fjpolo/ProtocolEmulatorr/html/Jane Street Blog - Can you design a chip_ Announcing the protocol emulator ASIC competition_files/youtube.png

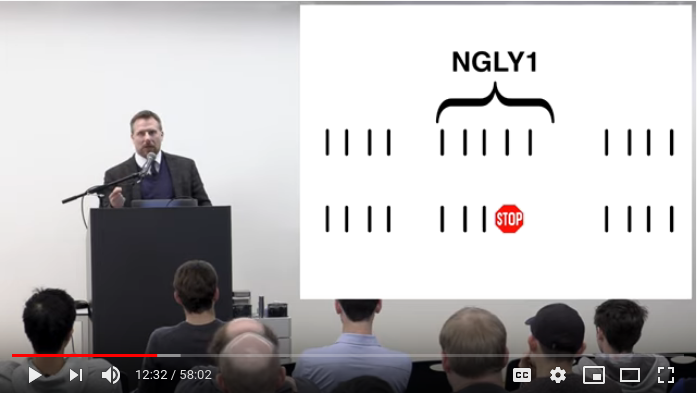
html/Jane Street Blog - Can you design a chip_ Announcing the protocol emulator ASIC competition_files/youtube.png
