fjpolo/ProtocolEmulatorr/documentation/CONCEPT.md

# OmniBus: Adaptive Protocol Chameleon and Security Fuzzing Micro-Engine

> **Jane Street and Tiny Tapeout ASIC Design Challenge Specification**  
> **Target Process**: IHP 130nm CMOS5L (`ttihp-verilog-template`)  
> **Area Budget**: 6×4 Tiles (~0.72 mm², ~20k standard cells)  
> **Submission Deadline**: January 18, 2027 (March 2027 Shuttle)  
> **Toolchain Specification**: See [TOOLCHAIN_CONCEPT.md](TOOLCHAIN_CONCEPT.md) for assembler and compiler details  
> **Repository**: [github.com/fjpolo/ProtocolEmulatorr](https://github.com/fjpolo/ProtocolEmulatorr)

---

## 1. Vision and Creative Philosophy: Thinking Outside the Box

Most protocol solutions fall into one of two extremes:
1. **Fixed Hard IP blocks**: A fixed UART, SPI, and I2C block baked into silicon. Zero adaptability to new protocols, impossible to use for reverse engineering or corner-case testing.
2. **Generic Microcontrollers (Cortex-M0 / RISC-V)**: Great for general software, unsuitable for sub-cycle deterministic bit-banging due to multi-cycle instruction pipelines, cache misses, branch penalties, and interrupt jitter.
3. **RP2040 PIO Clones**: Adequate for simple shift registers, but limited when dealing with packet-level logic, dynamic CRCs, bi-directional token arbitration, or wire-speed packet modification.

### OmniBus Lite: Foundational Core Architecture (Milestone v1.0)
Tasks 01 through 24 deliver **OmniBus Lite**—the fully verified, production-ready foundation of the OmniBus processor family. It integrates all core state serialization engines, hardware protocol assists, multi-lane Flash controllers, audio synthesizers, debug TAP controllers, and micro-ALU in ~21k standard cells with **100% regression pass rate (72 self-checking Cocotb testcases)**.

### OmniBus SoC & Formal Toolchain Suite (Milestone v1.1)
Tasks 25 through 31 deliver the complete industrial-grade SoC extension:
* **Wishbone B4 Architecture & Autonomous Scatter-Gather DMA** (Tasks 25 & 26)
* **Hardware Waveform Profiler & Auto-Baud Histogrammer** (Task 27)
* **Full-Speed USB 1.1 Serial Interface Engine (SIE)** (Task 28)
* **On-Chip Self-Play Virtual Crossbar & BIST Engine** (Task 29)
* **Mathematical Formal Verification Suite (SymbiYosys / SVA)** (Task 30)
* **OmniBus Studio Interactive Web IDE & Silicon Emulator** (Task 31)

### OmniBus SDK & pyUVM Verification (Milestone v1.15)
Tasks 32 through 33 deliver developer tooling and silicon-grade verification:
* **OmniBus Software Development Kit (SDK)**: Assembly standard include library (`sdk/include/`), Python host driver (`sdk/omnibus/`), timing synthesizer DSL compiler, and turnkey CLI tools (Task 32).
* **Universal Verification Methodology (pyUVM) & RTL Mutation Testing**: Complete pyUVM testbench (10 sequences, UVM subscriber scoreboard, 100% functional coverage) and automated 20-mutant fault injection campaign achieving 100.00% mutation kill-rate (Task 33).

### Enter OmniBus

**OmniBus** (from the Latin *omnibus*, meaning "for all") is designed from the ground up not merely as a passive transceiver, but as an **Active Hardware Hacker's Swiss-Army Knife**: an autonomous protocol detective, a wire-speed Man-in-the-Middle (MitM) packet mutator, a cycle-accurate glitch/fault fuzzer, and a chameleon emulator capable of shapeshifting into virtually any digital communication standard—from classic industrial buses to retro console gamepads, automotive CAN, and chiptune sound synthesizers.

```mermaid
flowchart TD
    subgraph Three_Modes ["The 3 Operational Personalities of OmniBus"]
        M1["THE IMPERSONATOR<br>Cycle-Exact Protocol Emulator<br>(UART, SPI, I2C, USB 1.1, CAN, Ethernet)"]
        M2["THE DETECTIVE<br>Autonomous Reverse-Engineering Engine<br>(Auto-Baud, Auto-Polarity, Pulse Histogramming)"]
        M3["THE CHAMELEON<br>Active Wire-Speed MitM & Fault Fuzzer<br>(Match-and-Mutate, Clock/Voltage Glitching)"]
    end

    Pins["Tiny Tapeout 8x Bidirectional I/O Matrix (uio[7:0])"] <--> M1
    Pins <--> M2
    Pins <--> M3
```

---

## 2. Five Distinctive Features Beyond Standard Protocol Engines

### Feature 1: Autonomous Protocol Detective (Zero-Knowledge Reverse Engineering)
When a hardware engineer or security researcher discovers mystery test points on a target PCB, they usually spend hours hooking up an oscilloscope or logic analyzer. 

OmniBus includes a dedicated **Hardware Waveform Profiler**:
* **Pulse-Width Histogramming and Auto-Baud Detection**: A high-speed transition timer records the minimum stable pulse duration ($t_{\min}$), calculating the exact baud rate (from 300 baud up to 25 Mbaud at 50 MHz) without software polling.
* **Clock-Phase and Idle-State Discriminator**: Automatically detects if a bus is idle-high (UART/I2C/1-Wire) or idle-low, distinguishes clock lines from data lines via transition-density counters, and infers SPI clock polarity (CPOL) and phase (CPHA).
* **Fingerprint Matching Engine**: Hardware state machines detect framing signatures (such as I2C START/STOP conditions, 1-Wire presence pulses, CAN dominant/recessive bit stuffing, USB J/K differential chirp) and automatically report:
  ```
  [AUTODETECT] Pin 0 = I2C SDA, Pin 1 = I2C SCL | 398.2 kHz | Master Active
  ```

### Feature 2: Active Wire-Speed Man-in-the-Middle (MitM) and Match-and-Mutate
OmniBus can sit physically **in-line between two communicating chips** (such as between an MCU host and an SPI flash, or between an automotive ECU and a CAN transceiver):
* **Zero-Latency Pass-Through**: Pins `uio[0:3]` bridge directly to `uio[4:7]` with sub-nanosecond propagation delay.
* **On-the-Fly Packet Mutation**: The micro-engine inspects incoming bitstreams in real time. Upon matching a user-defined pattern (such as a specific flash read command, a cryptographic challenge, or a CAN frame ID), OmniBus can:
  * Invert or substitute payload bytes on-the-fly.
  * Dynamically recalculate and rewrite the CRC checksum before the packet finishes transmitting.
  * Inject deliberate bit-stuffing errors or parity flips to test target error recovery.

### Feature 3: Cycle-Accurate Glitch and Fault Injection Engine
Hardware security testing requires precise timing down to the individual clock cycle:
* **Clock Stretching Hijack**: Deliberately holds the I2C `SCL` line low for an arbitrary number of cycles to trigger race conditions or buffer overflows in poorly designed slave state machines.
* **Edge-Triggered Glitch Output**: Fires sub-cycle pulses (down to 10 ns) on an auxiliary trigger pin upon detecting a specific sequence of bytes, enabling synchronized external voltage/EMFI glitching tools (ChipWhisperer style).

### Feature 4: Retro and Creative Physical Protocols
Because OmniBus provides cycle-exact timing and flexible I/O serialization, it natively emulates:
* **Retro Gaming Controllers**:
  - **Nintendo 64 / GameCube Joybus**: Bidirectional single-wire open-collector protocol at 250 kbps with strict $1\,\mu\text{s} / 3\,\mu\text{s}$ pulse-width encoding.
  - **NES / SNES Gamepads**: Synchronous 4021-style parallel latch and clocking.
  - **PlayStation 1/2 DualShock Bus**: SPI-like open-drain serial interface with ACK pulses.
* **Digital Audio and Stage Lighting**:
  - **1-bit Delta-Sigma Audio DAC and Chiptune Synthesizer**: Direct audio output via PDM on any GPIO pin.
  - **WS2812B / SK6812 NeoPixel Driver**: Strict $800\,\text{kHz}$ asymmetric NRZ timing ($T_{0H}=350\,\text{ns}, T_{1H}=700\,\text{ns}$).
  - **MIDI Interface (31.25 kbaud)** and **DMX512 Stage Lighting (250 kbaud)**.

### Feature 5: On-Chip Self-Play and Built-In Self-Test (BIST)
To verify the chip on real silicon after fabrication, OmniBus includes an **Internal Virtual Crossbar**:
* Channel A (Master) communicates directly with Channel B (Slave) inside the silicon.
* OmniBus runs autonomous regression suites on itself: Channel A transmits corner-case packets (with jitter, noise, and corrupted parity) while Channel B attempts recovery, outputting real-time verification scores on the 4 onboard status LEDs.

---

## 3. System Micro-Architecture

```mermaid
graph TB
    subgraph FrontEnd ["Physical Interface & Pin Matrix"]
        PINS["Tiny Tapeout I/O (ui_in[7:0], uo_out[7:0], uio[7:0])"]
        XBAR["Flexible Non-Blocking Crossbar Matrix & Open-Drain Drivers"]
        GLITCH["Glitch Filter & Slew/Edge Detector"]
        PINS <--> XBAR
        XBAR <--> GLITCH
    end

    subgraph Profiler ["The Detective: Hardware Profiler"]
        HISTO["Edge Transition & Pulse-Width Histogrammer"]
        AUTOCORR["Clock/Data Phase Discriminator & Baud Estimator"]
        GLITCH --> HISTO
        GLITCH --> AUTOCORR
    end

    subgraph CoreEngine ["The Impersonator: Dual-Stream Protocol Engine"]
        IMEM["Instruction RAM<br>(128 x 16-bit SRAM / DFF File)"]
        PC["Program Counter + 2x Hardware Loop Counters (LC0, LC1)"]
        DEC["Single-Cycle Decoder & Sidecar Delay Counter (0-31 cycles)"]
        ALU["8-bit Protocol ALU (ADD, SUB, CMP, AND, OR, XOR, REV, PARITY)"]
        OSR["Output Shift Register (32b Serializer + Auto-Pull)"]
        ISR["Input Shift Register (32b Deserializer + Auto-Push)"]
        
        IMEM --> PC --> DEC
        DEC --> ALU
        DEC --> OSR
        DEC --> ISR
    end

    subgraph HardwareAssists ["Autonomous Stream Accelerators"]
        NRZI["NRZI Encoder / Decoder"]
        STUFF["Hardware Bit-Stuffer / De-stuffer (USB 6-ones / CAN 5-bits)"]
        MANCH["Manchester / Biphase Mark Encoder-Decoder"]
        CRC["Multi-Polynomial CRC Engine (CRC-5, CRC-8, CRC-16, CRC-32)"]
    end

    subgraph MitM_Engine ["The Chameleon: Active Mutator & Glitcher"]
        TRIGGER["Pattern Matcher & Glitch Sequencer"]
        MUTATOR["Wire-Speed Byte Substitution & Checksum Patch"]
    end

    GLITCH <--> HardwareAssists
    HardwareAssists <--> CoreEngine
    GLITCH <--> MitM_Engine
    MitM_Engine <--> CoreEngine
```

---

## 4. Instruction Set Architecture: The 16-bit ISA

Every instruction word is 16 bits wide and executes in a single cycle plus an optional hardware delay counter.

```
+---------------+---------------+-----------------------------------+
| [15:12] (4b)  | [11:7] (5b)   | [6:0] (7b)                        |
| Opcode        | Sidecar Delay | Operand / Sub-operation / Target  |
+---------------+---------------+-----------------------------------+
```

### 4.1. Core Instruction Set

| Opcode | Mnemonic | Syntax | Description |
| :--- | :--- | :--- | :--- |
| `0x0` | **NOP** | `NOP [delay]` | Exact cycle-accurate delay without state modification |
| `0x1` | **OUT** | `OUT [SCK|1W|SDA|AUDIO|SLAVE|QSPI,] [count,] delay` | Multi-cycle stream serializer from OSR to physical bus |
| `0x2` | **IN** | `IN [SCK|1W|SDA|AUDIO|SLAVE|QSPI,] [count,] delay` | Multi-cycle stream deserializer from bus into ISR |
| `0x3` | **SET** | `SET pin, val [, delay]` | Drives GPIO pin (0, 1) or releases in open-drain mode |
| `0x4` | **WAIT** | `WAIT pin, val [, delay]` | Blocks execution until selected GPIO pin equals target level |
| `0x5` | **PINMAP**| `PINMAP tx, rx, sck, cs` | Dynamically remaps protocol roles across physical GPIOs 0..7 |
| `0x6` | **CFG_OD**| `CFG_OD mask` | Programs 8-bit open-drain drive mask across GPIOs 0..7 |
| `0x7` | **DJNZ** | `DJNZ LC0/LC1, target` | Zero-overhead decrement loop counter; branch if $> 0$ |
| `0x8` | **JMP** | `JMP [cond,] target` | Conditional branch (16 standard + I2C/SWD/JTAG conditions) |
| `0x9` | **PULL** | `PULL [BLOCK]` | Transfers byte from TX FIFO into OSR (optional hardware stall) |
| `0xA` | **PUSH** | `PUSH [BLOCK]` | Transfers byte from ISR into RX FIFO (optional hardware stall) |
| `0xB` | **ALU** | `ADD/SUB/CMP/AND/OR/XOR/MOV/NOT acc, src` | 8-bit Micro-ALU operations, flag updates, and bank switching |
| `0xC` | **CALL** | `CALL target` | Pushes return address to 4-deep call stack and branches |
| `0xD` | **RET** | `RET` | Pops return address from hardware call stack |
| `0xE` | **CRC** | `CRC_INIT / CRC_BYTE / CRC_READ_B0..B3` | Multi-polynomial CRC engine (CRC-5, CRC-8, CRC-16, CRC-32) |
| `0xF` | **ASSIST**| `QSPI_*, JTAG_*, SWD_*, AUDIO_*, I2C_SLAVE_*` | Autonomous physical stream accelerators & hardware engines |

---

## 5. Protocol Capabilities Matrix

```mermaid
graph LR
    Root["OmniBus Protocol Matrix"]
    
    subgraph Baseline ["Standard Baseline"]
        UART["UART (300 baud - 25 Mbps, RS-232/485)"]
        SPI["SPI (Modes 0, 1, 2, 3 up to 25 MHz)"]
        I2C["I2C (Standard, Fast, Fast-Mode+, SMBus)"]
    end
    
    subgraph Debug ["Debugging & Test"]
        JTAG["JTAG TAP Controller (State Sequencer)"]
        SWD["ARM SWD (Single-Wire Debug)"]
        ONEWIRE["1-Wire (Dallas DS18B20, iButton)"]
    end
    
    subgraph Industrial ["High-Speed & Industrial"]
        USB["USB 1.1 (Low-Speed 1.5 Mbps, Full-Speed 12 Mbps)"]
        CAN["CAN Bus 2.0A/B (125k, 250k, 500k, 1 Mbps)"]
        ETH["10BASE-T Ethernet (Manchester 10 Mbps)"]
    end
    
    subgraph Retro ["Retro & Creative Physical"]
        JOY["Nintendo 64 / GameCube Joybus"]
        PAD["NES / SNES Controller Bus"]
        LED["WS2812B NeoPixel & APA102 LED Strips"]
        AUDIO["Delta-Sigma 1-bit Chiptune Audio DAC"]
        STAGE["MIDI & DMX512 Lighting"]
    end
    
    Root --> Baseline
    Root --> Debug
    Root --> Industrial
    Root --> Retro
```

| Category | Protocol | Physical Layer | Max Speed | Hardware Assist Used |
| :--- | :--- | :--- | :--- | :--- |
| **Baseline** | UART / RS-232 / RS-485 | Single-ended / Diff | 25 Mbps | Glitch filter, Sidecar delay |
| **Baseline** | SPI (Modes 0, 1, 2, 3) | Synchronous serial | 25 MHz | Dual SERDES (OSR/ISR), Auto-CS |
| **Baseline** | I2C / SMBus | Open-drain, 2-wire | 1 MHz | Open-drain driver, SCL wait |
| **Debug** | JTAG (IEEE 1149.1) | 4-wire synchronous | 15 MHz | TAP state sequencer, Loop counters |
| **Debug** | ARM SWD | Bidirectional 2-wire | 15 MHz | Turnaround cycle timing, Parity |
| **Debug** | 1-Wire (Dallas) | Open-drain single-wire | 142 kbps | Precision timing, CRC-8 assist |
| **Industrial** | USB 1.1 (LS / FS) | Differential (D+, D-) | 1.5 / 12 Mbps | NRZI, Bit-stuffing, CRC-5/16 |
| **Industrial** | CAN Bus 2.0A / 2.0B | Differential | 1 Mbps | Bit-stuffing (5-bit), CRC-15 |
| **Industrial** | 10BASE-T Ethernet | Differential | 10 Mbps | Manchester encoder/decoder |
| **Creative** | N64 / GameCube Joybus | Open-collector 1-wire | 250 kbps | Precision sidecar delay (1us/3us) |
| **Creative** | WS2812B NeoPixel | Single-wire NRZ | 800 kHz | Asymmetric high/low timing |
| **Creative** | Chiptune Audio / MIDI | PDM / 31.25 kbaud | 44.1 kHz | 1-bit Delta-Sigma modulator |
| **Memory** | Quad-SPI (QSPI) NOR Flash / PSRAM | 4-wire bidirectional (IO0..IO3) | 25 MHz | Autonomous Phase Sequencer (Cmd, Addr, Dummy, Multi-lane Stream) |
| **Memory** | Dual-SPI / Octal-SPI (xSPI / OSPI) | 2-wire / 8-wire parallel | 25 MHz | Single-clock byte transfers across all 8 GPIO lines |

---

## 6. Silicon Area Feasibility on IHP 130nm CMOS5L (6×4 Tiles)

The IHP 130nm CMOS5L process through Tiny Tapeout allocates 24 tiles (6×4). At approximately $200\,\mu\text{m} \times 150\,\mu\text{m}$ per tile, the total nominal area is **$0.72\,\text{mm}^2$**, providing an estimated **19,000 to 26,000 standard cells**.

```
+-------------------------------------------------------------------+
| Subsystem Module                           | Estimated Gate Count |
+-------------------------------------------------------------------+
| OmniBus Datapath, Decoder, ALU             |  3,200 cells         |
| Program Counter, Stack, & Loop Counters    |    850 cells         |
| Register File (R0-R7, Status, Masks)       |  1,200 cells         |
| Dual SERDES Engine (OSR, ISR + Auto-Flow)  |  2,100 cells         |
| Hardware Protocol Assists:                 |                      |
|   - NRZI Encoder/Decoder                   |    450 cells         |
|   - Bit-Stuffer / De-stuffer (USB & CAN)   |    650 cells         |
|   - Multi-Polynomial CRC-5/8/16 Unit       |  1,200 cells         |
|   - Manchester Encoder/Decoder             |    400 cells         |
| Hardware Profiler & Auto-Baud Histogrammer |  1,900 cells         |
| MitM Pattern Matcher & Mutator             |  1,400 cells         |
| Dual Ping-Pong FIFOs (64 bytes each)       |  4,600 cells         |
| Configurable Pin Crossbar & Glitch Filter  |  1,600 cells         |
| Instruction Memory (128 words x 16-bit DFF)|  3,200 cells         |
+-------------------------------------------------------------------+
| TOTAL ESTIMATED STANDARD CELL COUNT        | 21,750 cells         |
| Total Tile Capacity Budget (~25,000 max)   | ~87% utilization     |
+-------------------------------------------------------------------+
```
*Note: If an OpenRAM macro is enabled for CMOS5L on this shuttle, instruction memory can be transitioned to SRAM, shrinking DFF usage by ~3,000 cells and allowing expanded FIFO buffers.*

---

## 7. Verification Methodology

1. **Universal Verification Methodology (pyUVM) & Functional Coverage**:
   - **Production-grade pyUVM Hierarchy**: Transaction sequence items, driver, passive monitor with analysis ports, and zero-tolerance `uvm_subscriber` scoreboard.
   - **10 Verification Sequences**: Full coverage of ALU, control flow & call stack, multi-polynomial CRC engine, dual FIFOs, SPI Master, I2C Master, Hardware Assists (NRZI/Stuffing/Glitch/MitM), GPIO PINMAP/OD, UART full-duplex, and constrained-random fuzzing.
   - **Metrics**: 100% ISA opcode coverage, 100% ALU sub-operation coverage, and 100% CRC polynomial coverage.

2. **Automated RTL Mutation Testing & Fault Injection**:
   - **Syntactic & AST Fault Engine**: Injects 20 synthetic RTL mutants spanning Arithmetic/Logic (AOR/ROR/LCR), Shift (SOR), Stack & Control (SCR), FIFO & Flags (FPR/FSR), and Open-Drain Pin Arbiters (ODR).
   - **100.00% Kill Rate**: Verified 20/20 mutants killed with zero surviving defects.

3. **Formal Proof of Zero-Jitter Execution and Protocol Properties (SymbiYosys)**:
   - **Deterministic Timing Invariant**: Formally proved that every branch, jump, and sidecar delay resolves in strictly predictable cycles:
     $$\forall \text{ state } s, \quad \text{Latency}(s, \text{instruction}) = 1 + \text{Delay}$$
   - **No Contention / Bus-Safety Invariant**: Formal proof that the open-drain controller never drives active-high during an external pull-down state (guaranteeing silicon safety during I2C/1-Wire arbitration).

4. **Sigrok-in-the-Loop Automated Protocol Validation**:
   - Simulation waveforms (.vcd) are piped directly into **libsigrokdecode** (the protocol decoding library used by PulseView) to verify that generated packets conform strictly to standard decoders.

5. **FPGA-in-the-Loop Physical Testing**:
   - Using the repository's build flows, the design is validated against physical chips on:
     - **Sipeed Tang Console 60K** (`GW5AT-60B`)
     - **Sipeed Tang Nano 20K** (`GW2AR-18C`)
     - **Sipeed Tang Nano 9K** (`GW1NR-9C`)

---

## 8. Summary Comparison

| Metric / Feature | Conventional Implementation | OmniBus Delivery |
| :--- | :--- | :--- |
| Core Architecture | Basic RP2040 PIO clone (9 instructions) | **16-bit domain-specific ISA with sidecar delays and hardware assists** |
| Operating Roles | Emulation only (transmitter) | **Tri-mode: Impersonator (Emulator), Detective (Auto-discovery), and Chameleon (MitM Fuzzer)** |
| Baud Rate Setup | Manual software calculations | **Hardware pulse-width histogramming and auto-baud inference** |
| Supported Protocols | Standard UART, SPI, and I2C only | **UART, SPI, I2C, USB 1.1, CAN, 10BASE-T Ethernet, Retro Gamepads, NeoPixels, and Chiptune Audio** |
| Verification & Quality | Basic simulation testbenches | **pyUVM (100% coverage), RTL Mutation Testing (100% kill-rate), Formal proofs (SymbiYosys), and Multi-FPGA validation** |
