fjpolo/ProtocolEmulatorr/documentation/DATASHEET.md

# OmniBus ProtocolEmulator ASIC Datasheet
**High-Performance Autonomous Multi-Protocol Emulation Core**  
**Document Revision**: 1.15 (Architecture Release — Tasks 01 through 33)  
**Architecture Milestone**: OmniBus Production Silicon (v1.15 Release)  
**Target ASIC / FPGA**: Jane Street Silicon / Gowin GW5AST-LV138FPG676A / Generic ASIC Standard Cell  
**Dedicated User Guides**: [task33.md](task33.md) (pyUVM Verification & RTL Mutation Testing), [task32.md](task32.md) (Software Development Kit), [task31.md](task31.md) (Web IDE & Visual Emulator), [task30.md](task30.md) (Formal SVA Verification), [task28.md](task28.md) (USB 1.1 Autonomous SIE), [task27.md](task27.md) (Waveform Profiler & Auto-Baud), [GLITCH_MITM_USER_GUIDE.md](GLITCH_MITM_USER_GUIDE.md) (Fault Injection & MitM Fuzzing), [task26.md](task26.md) (OmniBus DMA Controller)  

---

## 1. Device Overview & Key Features

The **OmniBus ProtocolEmulator** is a deterministic, microcode-programmable physical-layer communications processor designed to replace dedicated fixed-function protocol controllers (UART, SPI, I2C Master/Slave, SMBus, 1-Wire, USB 1.1, CAN 2.0, WS2812B, NES/SNES Gamepad, 10BASE-T Ethernet, S/PDIF, DALI, 1-Bit Delta-Sigma Audio DAC, IEEE 1149.1 JTAG, ARM Serial Wire Debug SWD, Quad-SPI & Octal-SPI Multi-Lane Flash/PSRAM Host) with a unified, high-speed ASIC architecture.

```
                           +---------------------------------------+
                           |       OmniBus ProtocolEmulator        |
                           |                                       |
    [Host System] <======> | [Wishbone B4 Slave]   [128-word IMEM] | <======> [Physical Pins]
    (Wishbone / FIFO)      | [Synchronous Dual FIFO]  (4 Banks)    |          (8-bit Unified GPIO)
                           | [Micro-ALU]         [SERDES Engine]   |          - Push-Pull / OD
                           | [32-bit CRC Engine] [Pulse Engine]    |          - Dynamic PINMAP
                           | [Stream Stuffer]    [NRZI Modulator]  |          - Manchester / BMC
                           | [I2C Slave Engine]  [Clock Stretch]   |          - Open-Drain I2C
                           | [Delta-Sigma DAC]   [4-Voice APU]     |          - PDM / BTL Audio
                           +---------------------------------------+
```

### Key Architectural Specifications
- **USB 1.1 Autonomous Serial Interface Engine (Task 28)**:
  - **Zero-CPU Full-Speed (12 Mbps) & Low-Speed (1.5 Mbps) SIE**: Autonomous differential line decoding (`D+`, `D-` $\to$ J, K, SE0, SE1), mid-bit eye-diagram alignment, and hardware bit-stuffing/de-stuffing.
  - **Autonomous Packet Verification & Filtering**: Hardware SYNC lock (`0x80`), PID complement verification (`PID[7:4] == ~PID[3:0]`), 7-bit Device Address and 4-bit Endpoint parsing, and token CRC-5 validation.
  - **Hardware Data CRC-16 Engine & Auto-Handshake Responder**: Reflective polynomial CRC-16 computation ($G(x) = x^{16} + x^{15} + x^2 + 1$, residual `0xB001`) and autonomous sub-microsecond `ACK`, `NAK`, `STALL` handshake generation.
  - **Bus Reset & EOP Handling**: Autonomous detection of sustained SE0 ($\ge 32$ bit times) indicating Bus Reset, and valid End-of-Packet (EOP) framing detection.
  - **Full Host & Microcode Integration**: Wishbone slave registers (`0x60..0x6C`), microcode opcodes (`USB_CFG`, `USB_SIE_EN`, `USB_SIE_DIS`, `USB_SEND_ACK`, `USB_SEND_NAK`, `USB_SEND_STALL`, `USB_TX_TOKEN`, `USB_TX_DATA`), and `ASSIST READ` targets (`USB_STATUS`, `USB_TOKEN`, `USB_DATA`, `USB_ADDR`).
- **Task 29: On-Chip Self-Play & Virtual Crossbar (BIST Engine)**:
  - **Internal Virtual Crossbar**: Direct Self-Loopback, Split Dual-Channel (Channel A Master <-> Channel B Slave), and pseudo-random jitter/stress injection.
  - **Hardware BIST Scoring**: 16-bit Vector, Pass, and Fail counters with sticky fail flag and real-time LED visualizer.
  - **Memory Map & Opcodes**: Wishbone slave registers (`0x70..0x78`), microcode opcodes (`BIST_DIS`, `BIST_LOOP`, `BIST_SPLIT`, `BIST_JITTER`, `BIST_START`, `BIST_STOP`, `BIST_RST`, `BIST_PASS`, `BIST_FAIL`, `BIST_STAGE`), and `ASSIST READ` targets (`BIST_STATUS`, `BIST_PASS`, `BIST_FAIL`, `BIST_VEC`).
- **The Protocol Detective: Autonomous Waveform Profiler & Auto-Baud Engine (Task 27)**:
  - **Zero-Knowledge Hardware Pulse Analyzer**: 16-bit transition timer running at 50 MHz (20 ns resolution) tracking minimum stable high/low pulse widths ($t_{\min\_high}, t_{\min\_low}$) and fundamental bit period ($t_{\min}$ auto-baud divisor).
  - **Bus Idle State & Duty-Cycle Symmetry Discriminator**: Classifies idle polarity (Idle-High vs. Idle-Low) and discriminates between periodic clocks ($t_{	ext{high}} pprox t_{	ext{low}}$) and asynchronous serial data.
  - **Autonomous Framing Signature Recognizer**: Real-time identification of I2C START/STOP, UART start/stop frames, 1-Wire reset (>400 µs), and SPI clock/chip-select coordination.
  - **Configurable Noise Filter & Telemetry Registers**: Digital glitch suppression (1..15 cycles) and host Wishbone registers (`0x50..0x5C`) with microcode instructions (`PROFILER_CFG`, `PROFILER_ARM`, `PROFILER_STOP`, `PROFILER_RST`, `JMP PROFILER_DONE`, `JMP PROFILER_CLOCK`).
- **OmniBus DMA Scatter-Gather Controller & Host Memory Streamer (Task 26)**:
  - **32-Bit Wishbone B4 Master Interface**: Autonomous direct memory access engine driving host memory bus cycles (`o_m_wb_cyc`, `stb`, `we`, `addr`, `data`, `sel`) with sub-word byte masking.
  - **Dual-Channel Concurrent Streaming**: Independent TX (Host Memory $\to$ TX FIFO) and RX (RX FIFO $\to$ Host Memory) channels with round-robin memory bus arbitration.
  - **Hardware Scatter-Gather Descriptor Traversal**: 16-byte linked-list descriptor processor (`buf_addr`, `length/flags`, `next_desc`, `status`) with automatic in-place byte count writebacks and End-of-Transmission (EOT) termination.
  - **Hardware Interrupts & Abort**: Dedicated interrupt generation (`o_irq`) upon channel completion, with instantaneous soft abort reset control.
- **Deterministic Zero-Jitter Execution Engine**: Microcode instructions execute in single clock cycles with precision cycle-accurate sidecar delays (up to 5,110 cycles per bit or runtime dynamic baud divisor).
- **1-Bit Delta-Sigma Audio DAC & 4-Voice Chiptune APU Synthesizer**: 50 MHz 1st-order Delta-Sigma ($\Sigma$-$\Delta$) PDM modulator with $OSR = 1250\times$, single-ended and differential BTL outputs on GPIO pins, 4 polyphonic synthesizer voices (Pulse 1, Pulse 2 with 4 duty cycles, 16-step Triangle, 15-bit/7-bit Galois LFSR Noise), saturation-clamped mixer ($V \le 255$), autonomous hardware sound effects (`BEEP`, `BLIP`, `ERROR`, `COIN`, `LASER`, `SIREN`, `NOISE`), and single-cycle PCM streaming (`OUT AUDIO`).
- **Hardware Glitch / Fault Injection & Active Wire-Speed MitM Fuzzing Engine**:
  - **Sub-Cycle Precision Crowbar & Glitch Pulse Generation**: 16-bit countdown delay (0 to 65,535 clock cycles, 20 ns resolution @ 50 MHz), 8-bit pulse width duration (1 to 255 clock cycles), selectable polarity (active-High trigger pulse or active-Low crowbar pulldown), and independent target pin routing (any GPIO 0..7).
  - **Autonomous Wire-Speed Pattern Matcher**: Single-cycle pattern comparison (`mitm_match_byte[7:0]`) with configurable wildcard bitmask (`mitm_mask[7:0]`). Immediate zero-jitter autonomous trigger-on-match starts glitch countdown upon detecting matching payload byte in deserialized or serialized streams.
  - **Real-Time Wire-Speed Payload Mutation**: In-flight payload byte substitution (`mitm_replace_byte[7:0]`) or bitwise inversion (`~payload`) during live stream deserialization (`IN` / `PUSH`) and serialization (`PULL` / `OUT`) without bus stalling or CPU intervention.
  - **Hardware Status & Extended Jump Conditions**: Telemetry register (`ADDR_GLITCH = 0x24`) and zero-overhead conditional branch opcodes (`JMP GLITCH_DONE`, `JMP MATCH_FOUND`).
- **Quad-SPI (QSPI), Dual-SPI & Octal-SPI Multi-Lane Flash & PSRAM Hardware Host Controller**:
  - High-throughput multi-lane serial interface supporting Single (1-bit), Dual (2-bit), Quad (4-bit IO0..IO3), and Octal (8-bit across all 8 GPIO pins) modes.
  - **Autonomous Protocol Phase Sequencer**: Hardware automation of Instruction Phase (`QSPI_CMD`), Address Phase (`QSPI_ADDR 24|32` across active lanes), Dummy Clock Phase (`QSPI_DUMMY 0..15` with bus in Hi-Z), and multi-byte stream transfers (`IN QSPI`, `OUT QSPI`) with auto-clock toggling.
  - **Direct Memory Support**: High-speed communication with Winbond (W25Q128 Quad Fast Read `0xEB`), Macronix (MX25), Micron, ISSI, and APMemory (APS6404 QSPI PSRAM).
- **Dedicated Hardware JTAG TAP Controller & ARM SWD Hardware Sequencer (Supporting RISC-V DTM & ARM CoreSight)**:
  - **IEEE 1149.1 16-State JTAG TAP Controller**: Fully autonomous hardware FSM (`jtag_state`) with smart multi-clock TMS stepping (`JTAG_NAV RESET`, `IDLE`, `SHIFT_DR`, `SHIFT_IR`, `EXIT_TO_IDLE`), high-speed 1-to-8 bit Data/Instruction Register shifts with auto-Exit1-DR (`JTAG_SHIFT`), and RISC-V Debug Module (DTM) IDCODE/DTMCS/DMI scan support.
  - **ARM Serial Wire Debug (SWD / ADIv5) Host Engine**: Autonomous 8-bit Request packet generation with hardware Even Parity, automatic 1-cycle bus turnaround (`Trn`), 3-bit target ACK sampling (`001`=OK, `010`=WAIT, `100`=FAULT), 32-bit data read/write (`SWD_RD32`, `SWD_WR32`) with hardware parity verification, and autonomous 54-clock line reset with 16-bit `0xE79E` JTAG-to-SWD select sequence (`SWD_RESET`).
  - **Extended Debug Jump Conditions**: Zero-overhead conditional branches (`JMP SWD_OK`, `JMP SWD_WAIT`, `JMP SWD_FAULT`, `JMP JTAG_IDLE`).
- **128-Word Instruction Memory (IMEM)**: Dual-port, runtime-reconfigurable memory divided into 4 selectable 32-word banks (`BANK 0` through `BANK 3`) with in-band or Wishbone programming.
- **Dedicated Hardware I2C / SMBus Slave Engine**: Autonomous background SCL/SDA edge & framing detection (START, Repeated START, STOP), hardware 7-bit address comparator, automatic ACK assertion (leaving SDA floating on mismatch), hardware clock stretching holding SCL low until released, and microcode slave data transfers (`IN SLAVE`, `OUT SLAVE`).
- **8-Bit Unified Bidirectional GPIO Bus**: Any protocol role (`TX`, `RX`, `SCK`, `CS`) dynamically mappable to any GPIO pin (`PINMAP`) with per-pin open-drain control (`CFG_OD`).
- **Single-Cycle 8-Bit Micro-ALU**: 16 arithmetic, logical, and bitwise operations (`ADD`, `ADC`, `SUB`, `SBB`, `AND`, `OR`, `XOR`, `NOT`, `NEG`, `SHL`, `SHR`, `ROL`, `ROR`, `SWAP`, `MOV`, `CLR`) with hardware `Zero` and `Carry` flags.
- **Hardware Subroutine Stack**: 4-deep call stack (`CALL`, `RET`) with 2-bit saturating pointer for modular protocol routines.
- **Zero-Overhead Loop Counters**: Dual independent 8-bit counters (`LC0`, `LC1`) with decrement-and-jump-if-not-zero (`DJNZ`) and register exchange instructions.
- **32-Bit Hardware Multi-Polynomial CRC Engine**: Single-cycle parallel 8-bit XOR tree supporting:
  - **CRC-32 (IEEE 802.3 10BASE-T Ethernet FCS / ZIP / PNG)**: Reflected polynomial `0xEDB88320`, seed `0xFFFFFFFF`.
  - **CRC-5 (USB 1.1 Token Packets)**: Reflected polynomial `0x14` ($x^5 + x^2 + 1$), seed `0x1F`.
  - **CRC-16 Modbus RTU / IBM**: Reflected polynomial `0xA001`, seed `0xFFFF`.
  - **CRC-16 CCITT / XMODEM**: Normal polynomial `0x1021`, seed `0x0000`.
  - **CRC-8 SMBus / I2C PEC**: Normal polynomial `0x07`, seed `0x00`.
  - **CRC-8 Dallas / 1-Wire**: Reflected polynomial `0x8C`, seed `0x00`.
  - Includes 4-byte readout (`CRC_READ_B0`, `B1`, `B2`, `B3`) and zero-overhead hardware residue verification (`JMP CRC_OK`, `JMP CRC_ERR`).
- **Autonomous Stream Accelerators**:
  - **Manchester & Biphase Mark Code (BMC) Engine**: Autonomous two-phase serializer/deserializer with half-bit delay scaling for **IEEE 802.3 10BASE-T Ethernet**, **Thomas convention**, and **BMC / FM1 (S/PDIF, DALI, MIL-STD-1553)**. Features continuous center-transition code violation detection (`manch_error`) and zero-overhead conditional branch (`JMP MANCH_ERR`).
  - **NRZI Modulator/Demodulator**: Hardware toggle-on-zero / hold-on-one encoder and single-cycle combinational edge detector.
  - **Hardware Bit-Stuffer / De-Stuffer**: Autonomous insertion and stripping of complementary bits for **USB 1.1** (stuff on 6 ones) and **CAN 2.0** (stuff on 5 identical bits) with hardware framing error latch (`stuff_error`) and conditional branch (`JMP STUFF_ERR`).
- **Asymmetric Single-Wire & Retro Physical Accelerators**:
  - **Single-Wire Pulse Serializer**: 2-phase asymmetric pulse generator with configurable active/rest periods for **WS2812B NeoPixel** (800 kHz NRZ) and **Nintendo N64 / GameCube Joybus** (250 kHz open-drain).
  - **Retro Gamepad Host Engine**: Autonomous 4-phase sequence generating latch pulses, clock bursts, and synchronous sampling for **NES (8-bit)** and **SNES (16-bit)** controllers.
- **Host System Interconnect**: Pipelined **Wishbone B4 Slave Wrapper** with dual parameterized synchronous FIFOs (TX/RX) and hardware status flags (`ADDR_STATUS[30]` for real-time I2C address match detection).

---

## 2. ASIC Pinout & Terminal Descriptions

### A. ASIC Package & Signal Interface Diagrams

#### 1. OmniBus Core Macro Signal Interface
The following diagram illustrates the functional terminal ports and bus widths of the synthesizable **OmniBus ProtocolEmulator Core**:

```
                                    +-----------------------------------+
                                    |         OmniBus Core Macro        |
                                    |        (RTL Terminal Ports)       |
                                    +-----------------------------------+
                     [Power & Clock]|                                   |[Unified Bidirectional GPIO]
                i_clk  -----------> |                                   | <---------> io_gpio[7:0] (Dynamic Role Matrix)
            i_reset_n  -----------> |                                   |
                                    |                                   |[Dedicated Role Convenience]
                [Host Data In / Out]|                                   | <---------- o_tx (UART TX / MOSI)
          i_data[7:0]  ===========> |                                   | <---------- o_spi_sck (SPI SCK)
          o_data[7:0]  <=========== |                                   | <---------- o_spi_cs_n (SPI CS#)
                                    |                                   | ----------> i_rx (UART RX / MISO)
              [FIFO Handshake Flags]|                                   |
           i_tx_valid  -----------> |                                   |[Dual-Port IMEM Bootloader]
             o_tx_pop  <----------- |                                   | ----------> i_prog_en (Core Freeze)
            i_rx_full  -----------> |                                   | ----------> i_prog_we (RAM Write Strobe)
            o_rx_push  <----------- |                                   | ==========> i_prog_addr[6:0] (0..127)
                                    |                                   | ==========> i_prog_data[15:0] (Instr In)
         [Dynamic Baud Rate Divisor]|                                   | <========== o_prog_rdata[15:0] (Readback)
     i_baud_div[15:0] ============> |                                   |
                                    +-----------------------------------+
```

#### 2. Discrete Standalone ASIC Package Pinout (LQFP-100 / QFN-100)
When deployed as a dedicated standalone IC exposing all internal parallel programming buses and dynamic prescalers directly to off-chip pins, the full 100-pin mapping is assigned as follows:

```
+---------------------+-------------------+---------------------+---------------------------------------------------------+
| Pin Group           | Pin Numbers (100) | Signal Name         | Width & Direction  | Description                        |
+---------------------+-------------------+---------------------+--------------------+------------------------------------+
| Power & Clock       | 1                 | i_clk               | 1-bit Input        | 50 MHz Master Clock                |
|                     | 2                 | i_reset_n           | 1-bit Input        | Active-Low Master Reset            |
|                     | 3, 24, 45, 62, 80 | VDD / VSS           | Power / Ground     | Core & I/O Power Decoupling Rings  |
| Host Data I/O       | 4..11             | i_data[7:0]         | 8-bit Input        | Host TX FIFO Input Byte            |
|                     | 12..19            | o_data[7:0]         | 8-bit Output       | Host RX FIFO Output Byte           |
| FIFO Handshaking    | 20                | i_tx_valid          | 1-bit Input        | TX Data Available Strobe           |
|                     | 21                | o_tx_pop            | 1-bit Output       | TX Pop Strobe on PULL              |
|                     | 22                | i_rx_full           | 1-bit Input        | RX FIFO Full Stall Strobe          |
|                     | 23                | o_rx_push           | 1-bit Output       | RX Push Strobe on PUSH             |
| Dynamic Prescaler   | 25..40 (16 pins!) | i_baud_div[15:0]    | 16-bit Input       | Baud Rate Prescaler (Cycles/Bit-1) |
| Dedicated Aliases   | 41                | o_tx                | 1-bit Output       | Dedicated Legacy UART TX / MOSI    |
|                     | 42                | o_spi_sck           | 1-bit Output       | Dedicated Legacy SPI SCK           |
|                     | 43                | o_spi_cs_n          | 1-bit Output       | Dedicated Legacy SPI CS#           |
|                     | 44                | i_rx                | 1-bit Input        | Dedicated Legacy UART RX / MISO    |
| Unified GPIO Bus    | 46..53 (8 pins)   | io_gpio[7:0]        | 8-bit Bidirect     | Reconfigurable PINMAP Matrix       |
| IMEM Bootloader     | 54                | i_prog_en           | 1-bit Input        | Bootloader Core Freeze Mode        |
|                     | 55                | i_prog_we           | 1-bit Input        | IMEM Synchronous Write Strobe      |
|                     | 56..61, 63 (7b)   | i_prog_addr[6:0]    | 7-bit Input        | IMEM Word Address (0..127)         |
|                     | 64..79 (16 pins)  | i_prog_data[15:0]   | 16-bit Input       | IMEM Instruction Write Word        |
|                     | 81..96 (16 pins)  | o_prog_rdata[15:0]  | 16-bit Output      | IMEM Instruction Readback Word     |
| Telemetry & Debug   | 97..100           | dbg_status[3:0]     | 4-bit Output       | BIST, Profiler, and Error Status   |
+---------------------+-------------------+---------------------+--------------------+------------------------------------+
```

#### 3. Tiny Tapeout 6×4 ASIC Allocation (IHP 130nm CMOS5L — 24 I/Os)
In Tiny Tapeout and standard embedded SoC designs (e.g. QFP-48 / QFN-48), the 16-bit baud divisor `i_baud_div[15:0]` and 128-word IMEM are dynamically configured in-band through [`OmniBootloader`](file:///c:/Workspace/ASIC/ProtocolEmulator/rtl/OmniBootloader.v) or the Wishbone B4 bus, requiring only 24 physical pads:

* **`ui_in[7:0]` (8 Dedicated Inputs)**:
  - `ui_in[0]`: UART RX (Bootloader microcode loading & dynamic `i_baud_div` configuration)
  - `ui_in[1]`: Host TX Valid / Wishbone STB
  - `ui_in[7:2]`: Host Data / Wishbone Address & Control
* **`uo_out[7:0]` (8 Dedicated Outputs)**:
  - `uo_out[0]`: UART TX (Bootloader telemetry, echo, and IMEM readback)
  - `uo_out[1]`: Glitch / Crowbar Hardware Fault Trigger Output
  - `uo_out[3:2]`: FIFO Pop / Push Strobes
  - `uo_out[7:4]`: Real-Time BIST Score & Status LEDs
* **`uio[7:0]` (8 Bidirectional I/Os)**:
  - `uio[7:0]`: Unified Bidirectional GPIO Bus (`io_gpio[7:0]`), individually switchable between drive, open-drain pull-down, and high-impedance input.

### B. Logical IO Interconnect Diagram

```mermaid
graph LR
    subgraph PwrClk ["Power & Clocking"]
        i_clk["i_clk<br/>(Master Clock, 50MHz)"]
        i_reset_n["i_reset_n<br/>(Active-Low Reset)"]
    end

    subgraph DataBus ["Host Data & FIFO Interface"]
        i_data["i_data[7:0]<br/>(TX FIFO Data In)"]
        o_data["o_data[7:0]<br/>(RX FIFO Data Out)"]
        i_tx_valid["i_tx_valid<br/>(TX Data Available)"]
        o_tx_pop["o_tx_pop<br/>(TX FIFO Pop Strobe)"]
        i_rx_full["i_rx_full<br/>(RX FIFO Full Stall)"]
        o_rx_push["o_rx_push<br/>(RX FIFO Push Strobe)"]
    end

    subgraph Prescaler ["Baud Prescaler"]
        i_baud_div["i_baud_div[15:0]<br/>(16-bit Prescaler)"]
    end

    subgraph Core ["OmniBus Core Engine"]
        ALU_CORE["Micro-ALU & SERDES<br/>128-word IMEM (4 Banks)<br/>Hardware Accelerators"]
    end

    subgraph GPIOBus ["8-Bit Unified GPIO Bus (Dynamic PINMAP)"]
        gpio0["io_gpio[0]<br/>Default: TX / SDA / 1W"]
        gpio1["io_gpio[1]<br/>Default: SCK / SCL"]
        gpio2["io_gpio[2]<br/>Default: CS_n / LATCH"]
        gpio3["io_gpio[3]<br/>Auxiliary GPIO"]
        gpio4["io_gpio[4]<br/>Auxiliary GPIO"]
        gpio5["io_gpio[5]<br/>Auxiliary GPIO"]
        gpio6["io_gpio[6]<br/>Auxiliary GPIO"]
        gpio7["io_gpio[7]<br/>Auxiliary GPIO"]
    end

    subgraph ConvPorts ["Dedicated Convenience Ports"]
        o_tx["o_tx (Mirrors o_gpio[tx_pin])"]
        o_spi_sck["o_spi_sck (Mirrors o_gpio[sck_pin])"]
        o_spi_cs_n["o_spi_cs_n (Mirrors o_gpio[cs_pin])"]
        i_rx["i_rx (Legacy RX Input)"]
    end

    subgraph Bootloader ["Runtime IMEM Programming Port"]
        i_prog_en["i_prog_en (Freeze & Program)"]
        i_prog_we["i_prog_we (Write Enable)"]
        i_prog_addr["i_prog_addr[6:0] (Addr 0..127)"]
        i_prog_data["i_prog_data[15:0] (Data In)"]
        o_prog_rdata["o_prog_rdata[15:0] (Data Out)"]
    end

    PwrClk --> Core
    DataBus <--> Core
    Prescaler --> Core
    Bootloader <--> Core
    Core <--> GPIOBus
    Core --> ConvPorts
```

### C. Detailed Terminal Pin Table

| Terminal Name | Direction | Bus Width | IO Standard | Reset State | Detailed Functional Description |
| :--- | :---: | :---: | :---: | :---: | :--- |
| **`i_clk`** | Input | 1 bit | LVCMOS33 | — | Primary system clock. Nominal $50\,\text{MHz}$ (standard cell maximum $>100\,\text{MHz}$). |
| **`i_reset_n`** | Input | 1 bit | LVCMOS33 | — | Active-low asynchronous/synchronous system reset. Resets all registers, flushes pipelines, and sets `pc <= 0`. |
| **`i_data[7:0]`** | Input | 8 bits | LVCMOS33 | — | Byte data input from host TX FIFO into execution engine (`PULL` instruction). |
| **`o_data[7:0]`** | Output | 8 bits | LVCMOS33 | `8'h00` | Byte data output to host RX FIFO from execution engine (`PUSH` instruction). |
| **`i_tx_valid`** | Input | 1 bit | LVCMOS33 | Low | Asserted high when `i_data` contains a valid unconsumed byte in host TX FIFO. |
| **`o_tx_pop`** | Output | 1 bit | LVCMOS33 | Low | Single-cycle active-high pop strobe emitted when `PULL` successfully consumes a byte. |
| **`i_rx_full`** | Input | 1 bit | LVCMOS33 | Low | Asserted high when host RX FIFO is full (blocks `PUSH [BLOCK]` instruction). |
| **`o_rx_push`** | Output | 1 bit | LVCMOS33 | Low | Single-cycle active-high push strobe emitted when `PUSH` writes `o_data` to RX FIFO. |
| **`i_baud_div[15:0]`** | Input | 16 bits | LVCMOS33 | — | Dynamic baud divisor. Loaded into sidecar delay counters via `$BAUD` (`9'h1FF`) or `$HBAUD` (`9'h1FE`). |
| **`i_gpio[7:0]`** | Input | 8 bits | LVCMOS33 | — | Physical input levels from the 8 bidirectional pads. Synchronized by internal 2-stage synchronizer. |
| **`o_gpio[7:0]`** | Output | 8 bits | LVCMOS33 | `8'hFD` | Physical output drive levels. Bit 0 defaults high (TX idle), Bit 1 low (SCK idle), Bit 2 high (CS idle). |
| **`o_gpio_oe[7:0]`** | Output | 8 bits | LVCMOS33 | `8'h07` | Active-high output drive enables (1 = Drive level from `o_gpio`, 0 = Hi-Z tristate / input mode). |
| **`o_tx`** | Output | 1 bit | LVCMOS33 | High | Dedicated legacy UART TX output (internally wired to `o_gpio[tx_pin]`). |
| **`o_spi_sck`** | Output | 1 bit | LVCMOS33 | Low | Dedicated legacy SPI clock output (internally wired to `o_gpio[sck_pin]`). |
| **`o_spi_cs_n`** | Output | 1 bit | LVCMOS33 | High | Dedicated legacy SPI chip select (internally wired to `o_gpio[cs_pin]`). |
| **`i_rx`** | Input | 1 bit | LVCMOS33 | — | Dedicated legacy UART RX input (accessible when `rx_pin` is routed to legacy input). |
| **`i_prog_en`** | Input | 1 bit | LVCMOS33 | Low | Programming mode enable. Freezes core execution and transfers dual-port IMEM control to programming bus. |
| **`i_prog_we`** | Input | 1 bit | LVCMOS33 | Low | Synchronous write enable strobe for writing `i_prog_data` into IMEM at `i_prog_addr`. |
| **`i_prog_addr[6:0]`** | Input | 7 bits | LVCMOS33 | `7'd0` | Word address (0..127) within the 128-word IMEM space (spans Banks 0..3). |
| **`i_prog_data[15:0]`** | Input | 16 bits | LVCMOS33 | `16'd0` | 16-bit instruction word to write into IMEM. |
| **`o_prog_rdata[15:0]`**| Output | 16 bits | LVCMOS33 | `16'd0` | 16-bit instruction word readback from IMEM at `i_prog_addr` for verification. |

### D. GPIO Pin Function Multiplexing Matrix (`PINMAP`)

Any of the 8 physical GPIO pins (`io_gpio[0]` through `io_gpio[7]`) can be dynamically routed to any protocol role at runtime via the `PINMAP` instruction (`PINMAP tx=<n>, rx=<n>, sck=<n>, cs=<n>`):

| Pin Index | Default Role | UART Mode | SPI Master Mode | I2C Master Mode | 1-Wire Mode | NeoPixel Mode | Joybus Mode | NES/SNES Host |
| :---: | :---: | :---: | :---: | :---: | :---: | :---: | :---: | :---: |
| **`io_gpio[0]`** | `TX / MOSI` | `TXD` | `MOSI` | `SDA (OD)` | `1W_DATA (OD)`| `PULSE_OUT` | `JOY_DATA (OD)`| `DATA_IN` |
| **`io_gpio[1]`** | `SCK / SCL` | `RTS_n` | `SCK` | `SCL (OD)` | GPIO | GPIO | GPIO | `CLOCK_OUT` |
| **`io_gpio[2]`** | `CS_n / LATCH`| `CTS_n` | `CS_n` | GPIO | GPIO | GPIO | GPIO | `LATCH_OUT` |
| **`io_gpio[3]`** | `RX / MISO` | `RXD` | `MISO` | GPIO | GPIO | GPIO | GPIO | GPIO |
| **`io_gpio[4]`** | Auxiliary | GPIO | GPIO | GPIO | GPIO | GPIO | GPIO | GPIO |
| **`io_gpio[5]`** | Auxiliary | GPIO | GPIO | GPIO | GPIO | GPIO | GPIO | GPIO |
| **`io_gpio[6]`** | Auxiliary | GPIO | GPIO | GPIO | GPIO | GPIO | GPIO | GPIO |
| **`io_gpio[7]`** | Auxiliary | GPIO | GPIO | GPIO | GPIO | GPIO | GPIO | GPIO |

*(Note: Roles are 100% interchangeable across any pin 0..7. For example, `PINMAP tx=4, rx=5, sck=6, cs=7` remaps the entire 4-wire SPI bus to GPIOs 4–7 without modifying microcode instructions).*

## 3. Internal Block Diagram

```mermaid
graph TD
    subgraph Host_Interface [Host System Interconnect]
        WB[Wishbone B4 Slave Wrapper]
        TX_FIFO["TX FIFO (Parameterized Synchronous)"]
        RX_FIFO["RX FIFO (Parameterized Synchronous)"]
        WB <--> TX_FIFO
        WB <--> RX_FIFO
    end

    subgraph Memory_Subsystem [Instruction Memory & Program Flow]
        IMEM["Dual-Port IMEM (128 words x 16-bit)"]
        BANK_REG["Bank Selector (active_bank [1:0])"]
        PC["Program Counter (pc [6:0])"]
        STACK["Hardware Call Stack (4x 7-bit, sp [1:0])"]
        LC["Hardware Loop Counters (LC0, LC1 [7:0])"]
        PC --> IMEM
        BANK_REG --> IMEM
        STACK <--> PC
        LC <--> PC
    end

    subgraph Execution_Engine [Core Processing Units]
        IR["Instruction Register (16-bit)"]
        ALU["8-bit Micro-ALU (16 ops, Flags: Z, C)"]
        ACC["Accumulator (acc [7:0])"]
        CRC["Hardware CRC Engine (8/16-bit)"]
        OSR["Output Shift Register (osr [7:0])"]
        ISR["Input Shift Register (isr [7:0])"]
        PAD_REG["Gamepad Shift Register (16-bit)"]
        IMEM --> IR
        IR --> ALU
        ALU <--> ACC
        IR --> CRC
        CRC <--> OSR
        CRC <--> ISR
    end

    subgraph Physical_Layer [SERDES & Protocol Accelerators]
        PINMAP["Dynamic Pin Mapping (TX, RX, SCK, CS)"]
        OD_CTRL["Open-Drain Mask Controller (CFG_OD)"]
        BIT_STUFF["Autonomous Bit-Stuffer/De-Stuffer (USB/CAN)"]
        NRZI["Autonomous NRZI Modulator/Demodulator"]
        PULSE_GEN["Asymmetric Single-Wire Serializer (WS2812B/Joybus)"]
        GAMEPAD_HOST["NES/SNES Gamepad Host Controller Engine"]
        OSR --> BIT_STUFF --> NRZI --> PULSE_GEN --> PINMAP
        PINMAP --> NRZI --> BIT_STUFF --> ISR
        GAMEPAD_HOST --> PINMAP
        GAMEPAD_HOST --> PAD_REG
    end

    subgraph IO_Pads [External Interface]
        GPIO_IN["i_gpio [7:0]"]
        GPIO_OUT["o_gpio [7:0]"]
        GPIO_OE["o_gpio_oe [7:0]"]
    end

    PINMAP <--> IO_Pads
    OD_CTRL --> GPIO_OE
    TX_FIFO --> OSR
    ISR --> RX_FIFO
```

---

## 4. Register Organization & Memory Architecture

### A. Architectural Registers

| Register | Width | Reset Value | Functional Description |
| :--- | :--- | :--- | :--- |
| `pc` | 7 bits | `7'd0` | Current microcode execution pointer (0..127 across 4 banks). |
| `delay_cnt` | 16 bits | `16'd0` | Zero-jitter timing countdown timer. Freezes execution while non-zero. |
| `active_bank` | 2 bits | `2'b00` | Currently selected 32-word IMEM bank (0, 1, 2, or 3). |
| `acc` | 8 bits | `8'h00` | Micro-ALU working accumulator. |
| `zero_flag` | 1 bit | `1'b0` | ALU Zero flag. Set if last ALU result was 0x00. |
| `carry_flag` | 1 bit | `1'b0` | ALU Carry/Borrow flag. |
| `osr` | 8 bits | `8'h00` | Output Shift Register for multi-cycle serial transmission. |
| `isr` | 8 bits | `8'h00` | Input Shift Register for multi-cycle serial reception. |
| `sp` | 2 bits | `2'b00` | Subroutine call stack pointer (supports nesting depth 0..3). |
| `call_stack[0..3]` | 7 bits each | `7'd0` | LIFO storage for return program counter addresses. |
| `lc0` | 8 bits | `8'h00` | Primary hardware loop counter for `DJNZ LC0`. |
| `lc1` | 8 bits | `8'h00` | Secondary hardware loop counter for `DJNZ LC1`. |
| `crc_reg` | 32 bits | `32'h00000000` | Running CRC accumulator register (CRC-8, CRC-16, CRC-32, CRC-5). |
| `crc_seed` | 32 bits | `32'h00000000` | Initial polynomial seed register. |
| `crc_poly` | 3 bits | `3'b000` | Polynomial selector: `000`=CRC8-Dallas, `001`=CRC8-SMBus, `010`=CRC16-CCITT, `011`=CRC16-Modbus, `100`=CRC32-Ethernet, `101`=CRC5-USB. |
| `i2c_slave_en` | 1 bit | `1'b0` | Dedicated hardware I2C/SMBus slave engine enable. |
| `i2c_slave_addr` | 7 bits | `7'd0` | Programmable 7-bit slave address for hardware matching. |
| `i2c_stretch_en` | 1 bit | `1'b0` | SCL hardware clock stretching enable. |
| `i2c_addr_match` | 1 bit | `1'b0` | Hardware address match flag (also exposed in Wishbone Status bit 30). |
| `i2c_rw_bit` | 1 bit | `1'b0` | Latched direction bit of matching address (`0`=Write, `1`=Read). |
| `i2c_start_flag` | 1 bit | `1'b0` | Sticky bus START / Repeated START condition flag. |
| `i2c_stop_flag` | 1 bit | `1'b0` | Sticky bus STOP condition flag. |
| `i2c_bus_active` | 1 bit | `1'b0` | Bus busy status between START and STOP conditions. |
| `i2c_master_ack` | 1 bit | `1'b0` | Sampled Master ACK response (`1`=ACK / low, `0`=NACK / high). |
| `i2c_stretch_hold` | 1 bit | `1'b0` | Active SCL clock stretch pull-down status. |
| `tx_pin` | 3 bits | `3'd0` | GPIO index assigned to Protocol TX / MOSI / SDA output. |
| `rx_pin` | 3 bits | `3'd0` | GPIO index assigned to Protocol RX / MISO / SDA input. |
| `sck_pin` | 3 bits | `3'd1` | GPIO index assigned to Protocol SCK / SCL clock output. |
| `cs_pin` | 3 bits | `3'd2` | GPIO index assigned to Protocol CS_n / LATCH output. |
| `gpio_od` | 8 bits | `8'h00` | Open-drain mask: `1` = Pin operates in open-drain, `0` = Push-pull. |
| `assist_nrzi_en` | 1 bit | `1'b0` | Hardware NRZI modulator/demodulator enable. |
| `assist_stuff_mode`| 2 bits | `2'b00` | Bit-stuffing mode: `00`=Off, `01`=USB 1.1 (6 ones), `10`=CAN 2.0 (5 identical). |
| `stuff_error` | 1 bit | `1'b0` | Framing violation error flag asserted on illegal bit-stuffing runs. |
| `pulse_mode` | 2 bits | `2'b00` | `00`=Off, `01`=Pulse Serializer (WS2812B/Joybus), `10`=Gamepad Host (NES/SNES). |
| `pulse_polarity` | 1 bit | `1'b0` | `0`=Active High (NeoPixel), `1`=Active Low Open-Drain (Joybus). |
| `pulse_msb_first` | 1 bit | `1'b0` | `1`=MSB-first (NeoPixel), `0`=LSB-first (Joybus). |
| `t_act_0` | 8 bits | `8'd19` | Bit '0' active duration (cycles). Default 20 cycles @ 50 MHz (400 ns). |
| `t_rest_0` | 8 bits | `8'd41` | Bit '0' rest duration (cycles). Default 42 cycles @ 50 MHz (840 ns). |
| `t_act_1` | 8 bits | `8'd39` | Bit '1' active duration (cycles). Default 40 cycles @ 50 MHz (800 ns). |
| `t_rest_1` | 8 bits | `8'd21` | Bit '1' rest duration (cycles). Default 22 cycles @ 50 MHz (440 ns). |
| `t_latch` | 8 bits | `8'd60` | Gamepad LATCH pulse duration (cycles). |
| `pad_snes_16b` | 1 bit | `1'b0` | Gamepad format: `0`=8-bit NES mode, `1`=16-bit SNES mode. |
| `pad_shift_reg` | 16 bits | `16'h0000` | Hardware 16-bit storage register for SNES controller button states. |

### B. Wishbone B4 Slave Memory Map

The ProtocolEmulator provides a standard 32-bit pipelined Wishbone B4 slave interface for host microprocessors (RISC-V, ARM, host PC):

| Offset Address | Register Name | Access | Width | Description |
| :--- | :--- | :--- | :--- | :--- |
| **`0x00`** | `WB_REG_DATA` | R/W | 8 bits | Write to push into TX FIFO; read to pop from RX FIFO. |
| **`0x04`** | `WB_REG_STATUS` | R | 32 bits | Top-level status register:<br>`[31]`: Interrupt (`o_irq`)<br>`[30]`: **I2C Slave Address Match** (`i2c_addr_match`)<br>`[29]`: CRC Residue Zero (`crc_reg == 0`)<br>`[28:24]`: Core Program Counter (`pc[4:0]`)<br>`[23:16]`: RX FIFO Level<br>`[15:8]`: TX FIFO Level<br>`[7:0]`: FIFO status flags (Empty/Full/AFull/AEmpty). |
| **`0x08`** | `WB_REG_CTRL` | R/W | 8 bits | Core control: `[0]`=Soft Reset, `[1]`=Halt/Program Mode, `[2]`=TX Flush, `[3]`=RX Flush, `[4..6]`=IRQ Enable masks. |
| **`0x0C`** | `WB_REG_BAUD_DIV` | R/W | 16 bits | Runtime baud divisor prescaler register. |
| **`0x10`** | `WB_REG_GPIO` | R/W | 32 bits | GPIO pin readback, output level, and output enable read/write. |
| **`0x14`** | `WB_REG_IMEM_BANK` | R/W | 8 bits | Microcode memory bank select register (`[1:0]` = active bank 0..3). |
| **`0x18`** | `WB_REG_AUDIO` | R/W | 32 bits | Audio DAC & Chiptune Synthesizer control & telemetry:<br>`[0]`: `audio_en`<br>`[2:1]`: `audio_mode` (0=Off, 1=PCM, 2=Synth)<br>`[5:3]`: `audio_pin` (GPIO 0..7)<br>`[6]`: `audio_diff` (BTL complementary enable)<br>`[14:7]`: `audio_sample` (8-bit PCM sample)<br>`[18:15]`: `audio_preset` (Active preset ID)<br>`[31]`: `pdm_bit` (Instantaneous 1-bit PDM output monitor). |
| **`0x1C`** | `WB_REG_DEBUG` | R/W | 32 bits | Hardware JTAG TAP & ARM SWD Host status & telemetry:<br>`[0]`: `jtag_en`<br>`[4:1]`: `jtag_state[3:0]` (16-state TAP FSM)<br>`[5]`: `jtag_tms` (current TMS pin level)<br>`[6]`: `jtag_tck` (current TCK pin level)<br>`[7]`: `jtag_tdo_sampled` (last sampled TDO level)<br>`[8]`: `swd_en`<br>`[11:9]`: `swd_last_ack[2:0]` (`001`=OK, `010`=WAIT, `100`=FAULT)<br>`[12]`: `swd_parity_err` (sticky data parity error)<br>`[13]`: `swd_oe` (SWDIO output drive enable)<br>`[17:14]`: `swd_state[3:0]` (SWD hardware sequencer state). |
| **`0x20`** | `WB_REG_QSPI` | R | 32 bits | Hardware Quad-SPI Host status and telemetry:<br>`[0]`: `qspi_en`<br>`[2:1]`: `qspi_width[1:0]` (`00`=Single, `01`=Dual, `10`=Quad, `11`=Octal)<br>`[3]`: `qspi_cpol`<br>`[7:4]`: `qspi_state[3:0]` (`1`=CMD, `2`=ADDR, `3`=DUMMY, `4`=RX, `5`=TX)<br>`[15:8]`: `qspi_rx_byte[7:0]` (last byte deserialized across multi-lane bus)<br>`[31:16]`: `qspi_addr_reg[15:0]` (lower 16 bits of physical address register). |
| **`0x24`** | `WB_REG_GLITCH` | R | 32 bits | Hardware Glitch & MitM Fuzzing status and telemetry:<br>`[2:0]`: `glitch_pin[2:0]` (target GPIO 0..7)<br>`[3]`: `glitch_pol` (0=Active High, 1=Active Low crowbar)<br>`[4]`: `glitch_active` (countdown/pulse in progress)<br>`[5]`: `glitch_armed` (armed state)<br>`[6]`: `mitm_match_found` (sticky pattern match flag)<br>`[7]`: `glitch_fired` (sticky pulse completion flag)<br>`[15:8]`: `mitm_replace_byte[7:0]`<br>`[23:16]`: `glitch_timer[7:0]` (countdown timer lower byte)<br>`[31:24]`: `mitm_match_count[7:0]` (total match events detected). |
| **`0x80 – 0xFF`**| `WB_IMEM_APERTURE` | R/W | 16 bits | Direct access to 128 microcode memory words (Words 0..127 across banks). |

---

## 5. Complete Instruction Set Architecture (ISA)

The OmniBus instruction set consists of 16-bit words. Execution is strictly deterministic: instructions execute in 1 clock cycle unless an active multi-cycle serializer or sidecar delay countdown is pending.

```
+---------------+---------------+---------------+---------------+
| 15 14 13 12   | 11 10 9 8     | 7 6 5 4       | 3 2 1 0       |
+---------------+---------------+---------------+---------------+
| Opcode (4b)   | Sub-Op / Pin  | Data / Delay Field            |
+---------------+---------------+---------------+---------------+
```

### ISA Summary Reference Table

| Opcode | Mnemonic | Syntax | Description |
| :---: | :--- | :--- | :--- |
| **`0x0`** | `NOP` | `NOP [delay]` | No operation. Pauses core for `[delay]` clock cycles. |
| **`0x1`** | `OUT` | `OUT [tx], <count> [, delay]` | Serialize `<count>` bits from OSR to `tx_pin`. (Auto-SCK / 1W / Pulse). |
| | | `OUT SLAVE` | Transmit 8 bits from OSR MSB-first in I2C slave mode, sample master ACK. |
| | | `OUT AUDIO` | Single-cycle direct PCM sample load from OSR into Delta-Sigma audio DAC. |
| **`0x2`** | `IN` | `IN [rx], <count> [, delay]` | Deserialize `<count>` bits from `rx_pin` into ISR. (Auto-SCK / 1W / Gamepad). |
| | | `IN SLAVE` | Receive 8 bits in I2C slave mode on SCL rise, auto-ACK on 9th SCL. |
| | | `IN AUDIO` | Single-cycle capture of current audio sample from DAC into ISR and `o_data`. |
| **`0x3`** | `SET` | `SET <pin>, <val> [, delay]` | Set selected GPIO pin output level to `<val>` (`0` or `1`). |
| **`0x4`** | `WAIT` | `WAIT <pin>, <val> [, delay]`| Block core execution until GPIO pin matches `<val>`, then delay. |
| **`0x5`** | `PINMAP` | `PINMAP TX, RX, SCK, CS` | Dynamically assign pin indices (0..7) to protocol roles. |
| **`0x6`** | `CFG_OD` | `CFG_OD <mask>` | Configure 8-bit open-drain output enable mask. |
| **`0x7`** | `LOOP` | `DJNZ <lc>, <target>` | Decrement loop counter and branch to `<target>` if not zero. |
| | | `SET_LC <lc>, <imm8>` | Load 8-bit immediate value into loop counter `LC0` or `LC1`. |
| | | `PULL_LC <lc>` | Latch host input data `i_data` into loop counter. |
| | | `PUSH_LC <lc>` | Copy loop counter value to output register `o_data`. |
| | | `MOV_LC <dst>, <src>` | Transfer count value between `LC0` and `LC1`. |
| **`0x8`** | `JMP` | `JMP [cond,] <target>` | Jump to `<target>` (Standard: Always, Z, NZ, C, NC, FIFO flags, CRC_OK, CRC_ERR, STUFF_ERR, MANCH_ERR; Extended: I2C_MATCH, I2C_START, I2C_STOP, I2C_READ, I2C_WRITE, I2C_ACK, I2C_NACK, I2C_BUS_ACTIVE). |
| **`0x9`** | `PULL` | `PULL [BLOCK]` | Transfer byte from TX FIFO (`i_data`) into OSR. |
| **`0xA`** | `PUSH` | `PUSH [BLOCK]` | Transfer byte from ISR into RX FIFO (`o_data`). |
| **`0xB`** | `ALU` | `ALU <op> [, <operand>]` | Execute single-cycle arithmetic/logical operation on Accumulator. |
| **`0xC`** | `CALL` | `CALL <target>` | Push return address to hardware stack and branch to `<target>`. |
| | `RET` | `RET` | Pop return address from hardware stack and resume execution. |
| **`0xD`** | `BANK` | `BANK <0..3>` | Switch active 32-word IMEM execution bank (Banks 0..3). |
| **`0xE`** | `CRC` | `CRC <subop> [, <param>]`| Control 32-bit hardware CRC engine (INIT, BYTE, READ_B0..B3, RESET). |
| **`0xF`** | `ASSIST`| `ASSIST <subop> [, <cfg>]`| Control stream accelerators (NRZI, Bit-Stuffer, Pulse, Gamepad, I2C Slave). |

---

### Detailed Opcode Specifications

#### Opcode `0x1` — `OUT` (Multi-Protocol Serializer)
- **Format**: `16'b0001_MMM_S_CCCC_DDDDDDDD`
  - `MMM`: Serializer Mode:
    - `000`: Standard Asynchronous Serializer / Pulse Serializer
    - `001`: Synchronous SPI Mode (`OUT SCK`) — auto-toggles `sck_pin`
    - `010`: 1-Wire Mode (`OUT 1W`) — generates 11x bit slots (Write 0 / Write 1)
    - `011`: Synchronous I2C Mode (`OUT SDA`) — auto-toggles `sck_pin` (SCL)
    - `111`: **Dedicated I2C Slave Mode** (`OUT SLAVE`):
      - Shifts out 8 data bits from OSR MSB-first on SCL falling edges.
      - Samples Master ACK/NACK into `i2c_master_ack` on the 9th SCL rising edge.
      - If clock stretching is enabled and master ACKed (`i2c_master_ack == 1`), automatically pulls SCL low upon completing the transfer until microcode issues `I2C_RELEASE_SCL` or another `OUT SLAVE`.
  - `S`: 1-Wire bit slot mode (`0` = 8-bit byte, `1` = 1-bit slot for ROM search)
  - `CCCC`: Bit count (0 = 8 bits, 1..7 = 1..7 bits)
  - `DDDDDDDD`: Sidecar bit duration delay. Special sentinel `9'h1FF` selects `i_baud_div[8:0]`.

#### Opcode `0x2` — `IN` (Multi-Protocol Deserializer)
- **Format**: `16'b0010_MMM_S_CCCC_DDDDDDDD`
  - If `pulse_mode == 2'b10`: Autonomous **NES/SNES Gamepad Host Mode**. Emits `t_latch` pulse on `cs_pin`, bursts 8 or 16 clock cycles on `sck_pin`, and shifts buttons into `isr` and `pad_shift_reg`.
  - `MMM = 001`: Synchronous SPI Master Read (`IN SCK`).
  - `MMM = 010`: 1-Wire Master Read (`IN 1W`).
  - `MMM = 011`: Synchronous I2C Master Read (`IN SDA`).
  - `MMM = 111`: **Dedicated I2C Slave Mode** (`IN SLAVE`):
    - Synchronously deserializes 8 data bits from `tx_pin` (SDA) on SCL rising edges into `isr`.
    - Automatically drives SDA low (ACK) on the 9th SCL cycle.
    - If clock stretching is enabled, asserts `i2c_stretch_hold` on the falling edge of the 9th SCL clock.
    - Latches byte into `o_data <= isr` and advances PC upon completion.

#### Opcode `0x8` — `JMP` (Conditional & Flag Branching)
- **Format**:
  - **Standard Branch** (`instr[7] == 0`): `16'b1000_CCCC_0_AAAAAAA`
    - `AAAAAAA`: 7-bit branch target address (0..127).
    - `CCCC`: Condition Code:
      - `4'h0`: Unconditional (`JMP <addr>`)
      - `4'h1`: Zero (`JMP Z, <addr>`)
      - `4'h2`: Not Zero (`JMP NZ, <addr>`)
      - `4'h3`: Carry (`JMP C, <addr>`)
      - `4'h4`: Not Carry (`JMP NC, <addr>`)
      - `4'h5`: TX FIFO Not Full (`JMP TX_READY, <addr>`)
      - `4'h6`: RX FIFO Not Empty (`JMP RX_VALID, <addr>`)
      - `4'h7`: TX FIFO Empty (`JMP TX_EMPTY, <addr>`)
      - `4'h8`: RX FIFO Full (`JMP RX_FULL, <addr>`)
      - `4'hF`: Framing or Stream Violation (`JMP STUFF_ERR, <addr>` or `JMP MANCH_ERR, <addr>`)
  - **Extended I2C Slave Conditions** (`instr[7] == 1`): `16'b1000_0_CCC_1_AAAAAAA`
    - `instr[6:4]` (`CCC`): Extended Condition Code:
      - `3'b000` (`0x0`): `JMP I2C_MATCH, <addr>` (or `I2C_ADDR_MATCH`) — Branch if 7-bit slave address matched.
      - `3'b001` (`0x1`): `JMP I2C_START, <addr>` — Branch if I2C START or repeated START condition occurred.
      - `3'b010` (`0x2`): `JMP I2C_STOP, <addr>` — Branch if I2C STOP condition occurred.
      - `3'b011` (`0x3`): `JMP I2C_READ, <addr>` — Branch if matched direction bit is Read (`R/W == 1`).
      - `3'b100` (`0x4`): `JMP I2C_WRITE, <addr>` — Branch if matched direction bit is Write (`R/W == 0`).
      - `3'b101` (`0x5`): `JMP I2C_ACK, <addr>` — Branch if master acknowledged last byte (`i2c_master_ack == 1`).
      - `3'b110` (`0x6`): `JMP I2C_NACK, <addr>` — Branch if master negative-acknowledged (`i2c_master_ack == 0`).
      - `3'b111` (`0x7`): `JMP I2C_BUS_ACTIVE, <addr>` — Branch if bus is currently between START and STOP.
      - `4'h8` (`0x8`): `JMP SWD_OK, <addr>` — Branch if ARM SWD target returned ACK `001` (OK).
      - `4'h9` (`0x9`): `JMP SWD_WAIT, <addr>` — Branch if ARM SWD target returned ACK `010` (WAIT).
      - `4'hA` (`0xA`): `JMP SWD_FAULT, <addr>` — Branch if ARM SWD target returned ACK `100` (FAULT).
      - `4'hB` (`0xB`): `JMP JTAG_IDLE, <addr>` — Branch if JTAG TAP controller is in Run-Test/Idle state (`jtag_state == 4'h1`).
      - `4'hC` (`0xC`): `JMP GLITCH_DONE, <addr>` — Branch if hardware glitch pulse has fired and completed (`glitch_fired == 1`).
      - `4'hD` (`0xD`): `JMP MATCH_FOUND, <addr>` — Branch if MitM pattern match has occurred (`mitm_match_found == 1`).

#### Opcode `0xB` — `ALU` (8-Bit Arithmetic & Logic Unit)
- **Format**: `16'b1011_CCCC_DDDDDDDD`
  - `CCCC = 0x0`: `ADD acc, imm8`
  - `CCCC = 0x1`: `ADC acc, imm8` (Add with carry)
  - `CCCC = 0x2`: `SUB acc, imm8`
  - `CCCC = 0x3`: `SBB acc, imm8` (Subtract with borrow)
  - `CCCC = 0x4`: `AND acc, imm8`
  - `CCCC = 0x5`: `OR  acc, imm8`
  - `CCCC = 0x6`: `XOR acc, imm8`
  - `CCCC = 0x7`: `NOT acc`
  - `CCCC = 0x8`: `NEG acc` (Two's complement)
  - `CCCC = 0x9`: `SHL acc` (Shift left into carry)
  - `CCCC = 0xA`: `SHR acc` (Shift right into carry)
  - `CCCC = 0xB`: `ROL acc` (Rotate left through carry)
  - `CCCC = 0xC`: `ROR acc` (Rotate right through carry)
  - `CCCC = 0xD`: `SWAP acc` (Exchange upper and lower nibbles)
  - `CCCC = 0xE`: Register Transfer:
    - `instr[7:0] = 0x00`: `MOV acc, osr`
    - `instr[7:0] = 0x01`: `MOV osr, acc`
    - `instr[7:0] = 0x02`: `MOV acc, isr`
    - `instr[7:0] = 0x03`: `MOV isr, acc`
  - `CCCC = 0xF`: `CLR acc` (Clear accumulator and flags)

#### Opcode `0xE` — `CRC` (32-Bit Multi-Polynomial Hardware CRC Engine)
- **Format**: `16'b1110_SSS_AAAAAAAAA`
  - `SSS`: CRC Sub-operation:
    - `3'b000`: `CRC_INIT <poly>, <seed>`:
      - `instr[3] = 0` (Legacy polynomials): `instr[8:7]` selects Dallas CRC-8 (`00`), SMBus CRC-8 (`01`), CCITT CRC-16 (`10`), Modbus CRC-16 (`11`). `instr[6:5]` selects default (`00`), zero (`01`), or `0xFFFF` (`10`).
      - `instr[3] = 1` (Extended polynomials): `instr[2:1]` selects Ethernet CRC-32 (`00`, reflected `0xEDB88320`, default seed `0xFFFFFFFF`) or USB Token CRC-5 (`01`, reflected `0x14`, default seed `0x0000001F`). `instr[5:4]` selects default (`00`), zero (`01`), or ones (`10`).
    - `3'b001`: `CRC_BYTE OSR` — feeds `osr[7:0]` into CRC accelerator in a single clock cycle.
    - `3'b010`: `CRC_BYTE ISR` — feeds `isr[7:0]` into CRC accelerator in a single clock cycle.
    - `3'b011`: `CRC_BYTE DATA` — feeds TX FIFO byte (`i_data[7:0]`) into CRC accelerator.
    - `3'b100`: `CRC_READ_B0` / `CRC_READ_LOW` — copies `crc_reg[7:0]` to `osr` and `o_data`.
    - `3'b101`: `CRC_READ_B1` / `CRC_READ_HIGH` — copies `crc_reg[15:8]` to `osr` and `o_data`.
    - `3'b110`: `CRC_RESET` — restores `crc_reg <= crc_seed`.
    - `3'b111`: Extended 4-Byte Readout:
      - `instr[0] = 0`: `CRC_READ_B2` — copies `crc_reg[23:16]` to `osr` and `o_data`.
      - `instr[0] = 1`: `CRC_READ_B3` — copies `crc_reg[31:24]` to `osr` and `o_data`.

#### Opcode `0xF` — `ASSIST` (Hardware Physical Stream Accelerators & I2C Slave)
- **Format**: `16'b1111_SS_XXXXXXXXXX`
  - `SS = 00`:
    - `instr[9:8] = 00`: `ASSIST CFG`
      - `instr[4] = 0`: NRZI & Bit-Stuffing Configuration (`NRZI=<0|1>, STUFF=<0|USB|CAN> [, INIT=<0|1>]`)
      - `instr[4] = 1`: Manchester Accelerator Configuration (`MANCH=<0|1>, MODE=<0|1|2> [, INIT=<0|1>]`)
      - High-level syntax: `ASSIST MANCH, <IEEE | THOMAS | BMC>`
    - `instr[9:8] = 01`: `I2C_RELEASE_SCL` — Explicitly releases hardware clock stretch hold (`i2c_stretch_hold <= 0`).
    - `instr[9:8] = 10`: `I2C_SLAVE_DISABLE` — Disables hardware I2C slave engine (`i2c_slave_en <= 0`).
    - `instr[8:7] = 11`: Task 22 Delta-Sigma Audio DAC & Chiptune Synthesizer Sub-Operations (`instr[6:4]`):
      - `3'b000` (`0x0`): `AUDIO_CFG <mode> [, PIN=<pin>] [, DIFF=<0|1>]` — Configure mode (`OFF`, `PCM`, `SYNTH`), target pin (0..7), and BTL differential output.
      - `3'b001` (`0x1`): `AUDIO_VOL <vol>` — Set volume (0..15) for all 4 APU voices.
      - `3'b010` (`0x2`): `AUDIO_SAMPLE` — Load 8-bit sample from `acc` into `audio_sample`.
      - `3'b011` (`0x3`): `AUDIO_DUTY <v0_duty>, <v1_duty>` — Configure Pulse 1 / Pulse 2 duty cycles.
      - `3'b100` (`0x4`): `AUDIO_NOTE_LO <voice>` — Load low 8 bits of frequency divider from `acc` into voice (0..3).
      - `3'b101` (`0x5`): `AUDIO_NOTE_HI <voice>` — Load high 8 bits of frequency divider from `acc` into voice (0..3).
      - `3'b110` (`0x6`): `AUDIO_PLAY <preset>` — Trigger autonomous hardware sound effect preset (`BEEP`, `BLIP`, `ERROR`, `COIN`, `LASER`, `SIREN`, `NOISE`).
      - `3'b111` (`0x7`): `AUDIO_STOP` — Halt sound effect preset and silence voices.
  - `SS = 01`:
    - `instr[9:8] = 00`: `ASSIST RESET` (Clears bit-stuff counters, `stuff_error`, `manch_error`, and phase trackers)
    - `instr[9:8] = 01`: Hardware JTAG & ARM SWD Operations (`instr[7:4]`):
      - `4'h1`: `JTAG_CFG <0|1>` — Enable/disable hardware JTAG engine.
      - `4'h2`: `JTAG_TMS <count>, <pattern>` — Shift raw pattern out on TMS line.
      - `4'h3`: `JTAG_NAV <RESET | IDLE | SHIFT_DR | SHIFT_IR | EXIT_TO_IDLE>` — Autonomous multi-clock TAP navigation.
      - `4'h4`: `SWD_CFG <0|1>` — Enable/disable ARM SWD hardware host engine.
      - `4'h5`: `SWD_REQ <AP|DP>, <RD|WR>, <addr2>` — 8-bit packet header, Trn, 3-bit ACK sampling.
      - `4'h6`: `SWD_RESET [switch=0|1]` — 54-clock line reset and optional `0xE79E` JTAG-to-SWD sequence.
      - `4'h7`: `JTAG_SHIFT <count> [, EXIT=0|1]` — Shift 1..8 bits on TDI/TDO with optional TMS assertion on last bit.
      - `4'h8`: `SWD_RD32` — Read 32 data bits + parity bit + turnaround from target into `swd_data_reg`.
      - `4'h9`: `SWD_WR32` — Write turnaround + 32 data bits + parity bit from `swd_data_reg` to target.
      - `4'hA`: `SWD_LOAD <byte_idx>` — Load `acc` into byte 0..3 of `swd_data_reg`.
       - `4'hB`: `QSPI_CFG <en>, <width>, <cpol>` — Master enable and bus width configuration (`width`: 1=Single, 2=Dual, 4=Quad, 8=Octal).
       - `4'hC`: `QSPI_CS <0|1>` — Assert (`0`) or deassert (`1`) SPI Chip Select.
       - `4'hD`: `QSPI_CMD` — Transmit 8-bit command in `acc` on Lane 0 (MOSI).
       - `4'hE`: `QSPI_DUMMY <cycles>` — Clock $N$ dummy wait cycles (0..15) with bus in Hi-Z.
       - `4'hF`: `QSPI_ADDR <24|32>` / `QSPI_LOAD_ADDR <0..3>` — Serialize address or load address bytes from `acc`.
    - `instr[9:8] = 10`: `I2C_SLAVE_CFG <addr7> [, stretch=0|1]` — Configures 7-bit slave address `instr[6:0]` and clock stretch enable `instr[7]`.
    - `instr[9:8] = 11`: `I2C_RELEASE_SCL` — Releases hardware SCL stretch hold.
  - `SS = 10`: `ASSIST READ`
    - `instr[9:8] = 00`: Read status into `acc`: `{stuff_error, manch_error, manch_mode[1:0], manch_en, stuff_mode[1:0], nrzi_en}`
    - `instr[9:8] = 01`: Read upper byte of 16-bit SNES gamepad (`pad_shift_reg[15:8]`) into `acc`
    - `instr[9:8] = 10`:
      - `instr[7:6] = 00`:
        - `instr[5] = 0`: Gamepad upper byte (`pad_shift_reg[15:8]`)
        - `instr[5] = 1`: `ASSIST READ, GLITCH` — Read `{mitm_match_found, glitch_fired, glitch_armed, glitch_active, 1'b0, glitch_pin[2:0]}` into `acc`
      - `instr[7:6] = 01`: `ASSIST READ, JTAG` — Read `{jtag_tdo, jtag_state[3:0], jtag_tms, jtag_tck, jtag_en}` into `acc`
      - `instr[7:6] = 10`: `ASSIST READ, SWD_STATUS` — Read `{swd_last_ack[2:0], swd_parity_err, swd_en, 3'b0}` into `acc`
      - `instr[7:6] = 11`: `ASSIST READ, SWD_DATA, <0..3>` — Read byte 0..3 of `swd_data_reg` into `acc`, `isr`, and `o_data`
    - `instr[9:8] = 11`: `ASSIST READ ADDR` — Read received 7-bit slave address `i2c_rx_addr[6:0]` into `acc[6:0]`
  - `SS = 11`: Task 18 Pulse & Retro Gamepad Configurations:
    - `instr[9:8] = 00`: `ASSIST PULSE_CFG [, NEOPIXEL | JOYBUS]`
    - `instr[9:8] = 01`: `ASSIST GAMEPAD_CFG, <NES | SNES> [, LATCH=<cycles>]`
    - `instr[9:8] = 10`: `ASSIST PULSE_TIME0, <t_act_0>`
    - `instr[9:8] = 11`: `ASSIST PULSE_TIME1, <t_act_1>`
  - `SS = 01`, `instr[9:8] = 00`: Task 25 Hardware Glitch & MitM Engine Configurations:
    - `instr[7:0] = 0x00`: `GLITCH_DISARM` — Disarm glitch trigger
    - `instr[7:0] = 0x01`: `GLITCH_TRIG` — Manual software trigger glitch countdown
    - `instr[7:0] = 0x02`: `GLITCH_ARM 0` — Arm glitch engine for manual software trigger
    - `instr[7:0] = 0x03`: `GLITCH_ARM 1` — Arm glitch engine for autonomous trigger-on-match
    - `instr[7:0] = 0x04`: `MITM_DISABLE` — Disable wire-speed MitM engine
    - `instr[7:0] = 0x05`: `MITM_ENABLE` — Enable wire-speed MitM substitution engine
    - `instr[7:0] = 0x06`: `MITM_CLR` — Reset MitM match counter and sticky match flag
    - `instr[7:4] = 0x1`: `GLITCH_CFG <pin>, <pol>` — Configure glitch target pin (0..7) and polarity (0=High, 1=Low crowbar)
    - `instr[7:4] = 0x2`: `GLITCH_WIDTH <w>` — Configure glitch pulse width duration (1..15 or `acc`)
    - `instr[7:4] = 0x5`: `GLITCH_DELAY <d>` — Configure glitch countdown delay (1..15 or `acc`)
    - `instr[7:0] = 0x60`: `MITM_MATCH` — Load `mitm_match_byte <= acc`
    - `instr[7:0] = 0x70`: `MITM_REPLACE` — Load `mitm_replace_byte <= acc`
    - `instr[7:0] = 0x80`: `MITM_MASK` — Load `mitm_mask <= acc`

---

## 6. Physical Protocol Profiles & Timing Characteristics

### 1. WS2812B NeoPixel 800 kHz Profile
- **Clock**: Nominal 50 MHz system clock ($T_{clk} = 20\,\text{ns}$).
- **Logic 0**: 400 ns High (`t_act_0 = 19`, 20 cycles) + 840 ns Low (`t_rest_0 = 41`, 42 cycles). Total: $1.24\,\mu\text{s}$.
- **Logic 1**: 800 ns High (`t_act_1 = 39`, 40 cycles) + 440 ns Low (`t_rest_1 = 21`, 22 cycles). Total: $1.24\,\mu\text{s}$.
- **Reset Latch**: Drive line low for $>50\,\mu\text{s}$ using `SET tx, 0, 2500`.

### 2. Nintendo N64 / GameCube Joybus Profile
- **Bus Type**: Single-wire bi-directional open-drain with $1\,\text{k}\Omega$ pull-up resistor to 3.3V.
- **Clock**: 50 MHz system clock.
- **Logic 0**: 3 µs Low (`t_act_0 = 149`, 150 cycles) + 1 µs Hi-Z (`t_rest_0 = 49`, 50 cycles).
- **Logic 1**: 1 µs Low (`t_act_1 = 49`, 50 cycles) + 3 µs Hi-Z (`t_rest_1 = 149`, 150 cycles).
- **Stop Bit**: 1 µs Low + 2 µs Hi-Z.

### 3. NES / SNES Gamepad Controller Bus
- **Wiring**: 3-wire interface — `cs_pin` (LATCH), `sck_pin` (CLOCK), `rx_pin` (DATA, active-low pull-up).
- **LATCH Pulse**: Autonomous high pulse on `cs_pin` for `t_latch` cycles (default $1.2\,\mu\text{s}$).
- **Clock Burst**: Generates 8 pulses (NES) or 16 pulses (SNES) on `sck_pin` at half baud period.
- **Data Capture**:
  - NES (8 bits): A, B, SELECT, START, UP, DOWN, LEFT, RIGHT $\rightarrow$ latched in `isr`.
  - SNES (16 bits): Lower byte $\rightarrow$ `isr`, Upper byte $\rightarrow$ `pad_shift_reg[15:8]` (read via `ASSIST READ, PAD_HIGH`).

### 4. 10BASE-T Ethernet & Biphase Mark Code (BMC) Stream Profile
- **Encoding Formats**:
  - **IEEE 802.3 10BASE-T Ethernet**: Logic 0 = Low $\to$ High, Logic 1 = High $\to$ Low. Mid-bit transition mandatory.
  - **Thomas Convention**: Logic 0 = High $\to$ Low, Logic 1 = Low $\to$ High.
  - **Biphase Mark Code (BMC / FM1)**: Always toggle at boundary. Toggle at center if and only if bit is `'1'`. Used in **S/PDIF** and **DALI**.
- **Timing Resolution**: Configured via `eff_hdelay = eff_delay >> 1`.
  - For $10\,\text{Mbit/s}$ Ethernet at $50\,\text{MHz}$: Bit period = $100\,\text{ns}$ (5 cycles), half-bit = $50\,\text{ns}$ (2–3 cycles).
  - For $1.2\,\text{kbit/s}$ DALI at $50\,\text{MHz}$: Bit period = $833.33\,\mu\text{s}$, half-bit = $416.67\,\mu\text{s}$ (20,833 cycles).
- **Code Violation Detection**: Flatline across center transition flags `manch_error` in hardware and triggers zero-overhead `JMP MANCH_ERR` branch.

### 5. Dedicated Hardware I2C / SMBus Slave Engine
- **Bus Type**: 2-wire open-drain (`tx_pin` = SDA, `sck_pin` = SCL) with external $1.5\,\text{k}\Omega - 4.7\,\text{k}\Omega$ pull-up resistors to $V_{DDIO}$.
- **Speed Grades**: Standard-mode ($100\,\text{kHz}$), Fast-mode ($400\,\text{kHz}$), Fast-mode Plus ($1.0\,\text{MHz}$).
- **Autonomous Hardware Operation**:
  - Hardware state machine continuously monitors START / STOP / Repeated-START framing independent of core PC.
  - Deserializes 7-bit slave address and 1-bit R/W flag.
  - Compares with programmed `i2c_slave_addr[6:0]`:
    - **Match**: Automatically drives SDA low (ACK) during 9th SCL pulse, latches `i2c_addr_match = 1`, and optionally asserts clock stretch (`i2c_stretch_hold = 1`) on the 9th falling edge.
    - **Mismatch**: Floats SDA high (NACK), resets match flag, and ignores incoming payload until next START condition.
- **Hardware Clock Stretching**:
  - Configured by `stretch=1` in `I2C_SLAVE_CFG`.
  - Holds SCL low autonomously to pace slow microcode routines.
  - Microcode releases clock stretch by executing `I2C_RELEASE_SCL` or by issuing the next byte transfer (`OUT SLAVE`).
  - Automatically suppresses clock stretching if external master NACKs on read (`i2c_master_ack == 0`).
- **Wishbone Integration**:
  - Status register bit 30 (`WB_REG_STATUS[30]`) reflects real-time `i2c_addr_match`, enabling interrupt or polled DMA servicing.

### 6. 1-Bit Delta-Sigma Audio DAC & 4-Voice Chiptune PDM Engine
- **Modulator Architecture**: 1st-order Delta-Sigma ($\Sigma$-$\Delta$) Pulse Density Modulation running at $f_{clk} = 50\,\text{MHz}$.
  - Oversampling ratio ($OSR$): $1250\times$ over $40\,\text{kHz}$ audio bandwidth.
  - Linear 8-bit dynamic range with first-order high-pass quantization noise shaping.
- **Audio Output Modes**:
  - **Single-Ended PDM**: Direct output on selected GPIO pin (`audio_pin`), requiring only a simple external passive RC low-pass filter ($R \approx 1\,\text{k}\Omega$, $C \approx 10\,\text{nF}$, $f_c \approx 16\,\text{kHz}$).
  - **Differential Bridge-Tied Load (BTL)**: Generates complementary inverted PDM bitstream on `audio_pin ^ 1` (`audio_diff = 1`), doubling effective peak-to-peak output voltage (4x audio power) and eliminating DC bias across speakers.
- **4-Voice Polyphonic Chiptune APU Synthesizer**:
  - **Pulse Voices 0 & 1**: 16-bit programmable period divider ($f_{out} = \frac{f_{clk}}{16 \cdot (\text{period} + 1)}$), 4 selectable duty cycles (12.5%, 25%, 50%, 75%), 4-bit independent volume control (0..15).
  - **Triangle Voice 2**: 16-step smooth triangle wave generator with 4-bit volume control.
  - **Noise Voice 3**: 15-bit Galois pseudo-random LFSR with switchable 15-bit (white noise) and 7-bit (metallic periodic noise) modes and 4-bit volume control.
  - **Digital Mixer**: Real-time saturation-clamped summation ($V_0 + V_1 + V_2 + V_3 \le 255$).
- **Autonomous Hardware Sound Effects**: Built-in multi-step preset sequencer for instant sound generation without microcode polling (`BEEP`, `BLIP`, `ERROR`, `COIN`, `LASER`, `SIREN`, `NOISE`).
- **Direct PCM Streaming**: Single-cycle `OUT AUDIO` sample transfer from OSR directly to DAC for high-speed host PCM sample playback.

### 7. The Protocol Detective: Autonomous Waveform Profiler & Auto-Baud Subsystem (Task 27)
- **High-Speed Transition & Pulse Profiler**:
  - 16-bit transition timer running at 50 MHz (20 ns resolution) with first-edge synchronization.
  - Continuous minimum high pulse ($t_{\min\_high}$), minimum low pulse ($t_{\min\_low}$), and fundamental bit period ($t_{\min}$) tracking.
  - Line idle state discriminator (0 = Idle-Low, 1 = Idle-High).
  - Clock vs. Data duty-cycle symmetry discriminator (`is_clock = 1` when $|t_{\min\_high} - t_{\min\_low}| \le t_{\min}/4 + 2$ and no idle stretches).
  - Protocol framing signature detector: UART (1), I2C (2), SPI (3), 1-Wire (4).
- **Wishbone B4 Slave Memory Map (`0x50..0x5C`)**:
  - `0x50`: `ADDR_PROFILER_CTRL` (RW: `[2:0]`=pin_sel, `[6:3]`=glitch_filter, `[8]`=arm, `[9]`=stop, `[10]`=rst, `[11]`=irq_en).
  - `0x54`: `ADDR_PROFILER_STATUS` (RO: `[0]`=busy, `[1]`=done, `[2]`=idle_pol, `[3]`=is_clock, `[7:4]`=proto_id, `[15:8]`=edge_count).
  - `0x58`: `ADDR_PROFILER_TMIN` (RO: `[15:0]`=$t_{\min}$ baud divisor, `[31:16]`=$t_{\max}$).
  - `0x5C`: `ADDR_PROFILER_PERIOD` (RO: `[15:0]`=$t_{\min\_high}$, `[31:16]`=$t_{\min\_low}$).
- **Microcode Instructions & Extended Branch Flags**:
  - `PROFILER_CFG <pin> [, <filter>]` (`0xF490`), `PROFILER_FILTER <cycles>` (`0xF4A0`), `PROFILER_ARM` (`0xF408`), `PROFILER_STOP` (`0xF409`), `PROFILER_RST` (`0xF40A`).
  - `ASSIST READ, PROFILER_STATUS` (`0xFBC0`), `PROFILER_TMIN_L` (`0xFB80`), `PROFILER_TMIN_H` (`0xFBA0`), `PROFILER_EDGES` (`0xFBE0`).
  - Extended Branches: `JMP PROFILER_DONE, <target>` (`0x8E..`), `JMP PROFILER_CLOCK, <target>` (`0x8F..`).

### 8. OmniBus DMA Scatter-Gather Controller & Host Memory Streamer (Task 26)
- **Wishbone B4 Master Bus Interface**:
  - `o_m_wb_cyc`, `o_m_wb_stb`, `o_m_wb_we`, `o_m_wb_addr[31:0]`, `o_m_wb_data[31:0]`, `o_m_wb_sel[3:0]`.
  - Driven with single-cycle pipelined transactions, automatic sub-word byte masking, and round-robin bus arbitration between TX and RX channels.
- **DMA Channel Control & Status Registers (Wishbone Slave Base `0x30..0x4C`)**:
  - `0x30`: `ADDR_DMA_CTRL` (`tx_en`, `tx_start`, `tx_irq_en`, `tx_sg_en`, `rx_en`, `rx_start`, `rx_irq_en`, `rx_sg_en`, `abort`).
  - `0x34`: `ADDR_DMA_STATUS` (`tx_busy`, `tx_done`, `tx_err`, `rx_busy`, `rx_done`, `rx_err`, `irq`).
  - `0x38`: `ADDR_DMA_TX_ADDR` (Host memory source pointer / Descriptor head).
  - `0x3C`: `ADDR_DMA_TX_LEN` (TX transfer length in bytes, 1..65535).
  - `0x40`: `ADDR_DMA_RX_ADDR` (Host memory destination pointer / Descriptor head).
  - `0x44`: `ADDR_DMA_RX_LEN` (RX transfer length in bytes, 1..65535).
  - `0x48`: `ADDR_DMA_TX_DESC` (Current TX descriptor readback).
  - `0x4C`: `ADDR_DMA_RX_DESC` (Current RX descriptor readback).
- **16-Byte Scatter-Gather Descriptor Architecture**:
  - **Word 0 (+0x00)**: `buf_addr[31:0]` (Host memory buffer pointer).
  - **Word 1 (+0x04)**: `[31:16]` = Flags (Bit 0 = EOT: End of Table), `[15:0]` = Transfer Length.
  - **Word 2 (+0x08)**: `next_desc[31:0]` (Pointer to subsequent descriptor in host RAM).
  - **Word 3 (+0x0C)**: `[15:0]` = Status / Transferred Bytes (Written back by DMA master upon completing buffer).
### 9. USB 1.1 Autonomous Serial Interface Engine (Task 28)
- **High-Speed Hardware Physical Layer & Packet Processor**:
  - Differential line state recovery (`D+`, `D-` $\to$ J, K, SE0, SE1) with 2-stage double-flop synchronizer.
  - Full-Speed ($12\,\text{Mbps}$) and Low-Speed ($1.5\,\text{Mbps}$) support with mid-bit eye-diagram alignment ($0.5T, 1.5T, \dots$).
  - Autonomous NRZI decoding and hardware bit-stuffing/de-stuffing.
  - Automatic SYNC lock (`0x80`), PID complement verification (`PID[7:4] == ~PID[3:0]`), Device Address filtering (`ADDR[6:0]`), Endpoint extraction (`ENDP[3:0]`), and CRC-5 validation (residual `0x06`).
  - Hardware 16-bit CRC data engine ($G(x) = x^{16} + x^{15} + x^2 + 1$, residual `0xB001`).
  - Autonomous hardware handshake generation (`ACK`, `NAK`, `STALL`) with sub-microsecond turnaround time.
  - Bus Reset detection on sustained SE0 ($\ge 32$ bit times) and EOP framing validation.
- **Wishbone B4 Slave Memory Map (`0x60..0x6C`)**:
  - `0x60`: `ADDR_USB_CTRL` (RW: `[0]`=sie_en, `[1]`=speed_mode, `[2]`=auto_ack, `[9:3]`=dev_addr, `[25:10]`=bit_div).
  - `0x64`: `ADDR_USB_STATUS` (RO: `[7:0]`=status_byte, `[11:8]`=token_pid, `[15:12]`=token_endp, `[22:16]`=token_addr, `[27:24]`=rx_pid, `[28]`=bus_reset, `[29]`=bus_idle).
  - `0x68`: `ADDR_USB_EP_CTRL` (RW: `[3:0]`=ep_stall, `[7:4]`=ep_nak, `[11:8]`=ep_toggle).
  - `0x6C`: `ADDR_USB_TX_TOKEN` (WO: `[3:0]`=tx_token_pid, `[10:4]`=tx_token_addr, `[14:11]`=tx_token_endp, `[19:16]`=tx_handshake_pid, `[20]`=tx_handshake_req).
- **Microcode Instructions & Extended Telemetry**:
  - `USB_CFG <addr>` (`0xF4B[addr]`), `USB_SIE_EN` (`0xF40B`), `USB_SIE_DIS` (`0xF40C`), `USB_SEND_ACK` (`0xF40D`), `USB_SEND_NAK` (`0xF40E`), `USB_SEND_STALL` (`0xF40F`), `USB_TX_TOKEN <pid>` (`0xF4C[pid]`), `USB_TX_DATA <pid>` (`0xF4D[pid]`).
  - `ASSIST READ, USB_STATUS` (`0xFB10`), `USB_TOKEN` (`0xFB30`), `USB_DATA` (`0xFB50`), `USB_ADDR` (`0xFB70`).

### 9. On-Chip Self-Play & Virtual Crossbar (BIST Engine)
- **Virtual Crossbar Routing Modes**:
  - `00`: Pass-through mode (external package pins `i_gpio`).
  - `01`: Direct Self-Loopback (`o_gpio[p] -> core_in[p]`).
  - `10`: Split Dual-Channel crossbar: Lower nibble (0..3) Channel A Master <-> Upper nibble (4..7) Channel B Slave.
  - `11`: Pseudo-random LFSR jitter and error stress injection mode.
- **Hardware Scoring Engine**:
  - 16-bit Vector Counter (`bist_vec_cnt`), 16-bit Pass Counter (`bist_pass_cnt`), 16-bit Fail Counter (`bist_fail_cnt`), and sticky error flag.
  - Real-time LED visualizer telemetry: LED 7 (Error Flag), LED 6..4 (Stage 1..7), LED 3 (Active), LED 2..0 (Live Crossbar Bus).
- **Wishbone B4 Slave Memory Map (`0x70..0x78`)**:
  - `0x70`: `ADDR_BIST_CTRL` (RW: `[1:0]`=mode, `[2]`=jitter_en, `[3]`=bist_en, `[4]`=start, `[5]`=stop, `[6]`=rst, `[11:8]`=stage).
  - `0x74`: `ADDR_BIST_STATUS` (RO: `[0]`=active, `[1]`=fail_flag, `[3:2]`=mode, `[7:4]`=stage, `[23:8]`=fail_cnt).
  - `0x78`: `ADDR_BIST_SCORES` (RO: `[15:0]`=vec_cnt, `[31:16]`=pass_cnt).
- **Microcode Instructions & Extended Telemetry**:
  - `BIST_DIS` (`0xF4E0`), `BIST_LOOP` (`0xF4E1`), `BIST_SPLIT` (`0xF4E2`), `BIST_JITTER` (`0xF4E3`), `BIST_START` (`0xF4E4`), `BIST_STOP` (`0xF4E5`), `BIST_RST` (`0xF4E6`), `BIST_PASS` (`0xF4E7`), `BIST_FAIL` (`0xF4E8`), `BIST_STAGE <n>` (`0xF4F[n]`).
### 10. Multi-Core Symmetric OmniBus Micro-Engine (OmniBus MP — Task 35)
- **Parameterized Symmetric Multi-Core Slices**:
  - Parameterized synthesis configuration with 1, 2, or 4 independent execution cores (`NUM_CORES = 1, 2, 4`).
  - Core reset vectors: $\text{RESET\_PC} = \text{CORE\_ID} \times 32$ (Bank 0: 0x00, Bank 1: 0x20, Bank 2: 0x40, Bank 3: 0x60).
  - Private register files (`ACC`, `OSR`, `ISR`, `R0..R7`, `LC0`, `LC1`) per core.
- **Hardware Synchronization & Inter-Core Fabric**:
  - **8 Shared Mailboxes (`MAILBOX[0..7]`)**: Single-cycle read/write access from microcode (`MB_READ`, `MB_WRITE`) and host Wishbone window (`0x7C`).
  - **4 Single-Cycle Atomic Spinlocks (`SPINLOCK[0..3]`)**: Hardware test-and-set mutual exclusion with atomic grant (`SPINLOCK_ACQ`) and release (`SPINLOCK_REL`).
  - **Hardware Rendezvous Barrier (`BARRIER_WAIT`)**: Zero-overhead phase-locked synchronization across all active cores.
  - **Circular Cascade FIFO Crossbar**: Low-latency inter-core stream routing from Core $i$ to Core $(i+1) \bmod N$.
- **Wishbone B4 Slave Memory Map (`0x28`, `0x2C`, `0x7C`)**:
  - `0x28`: `ADDR_MP_CTRL` (RW: `[3:0]`=core_en, `[4]`=barrier_rst, `[5]`=stream_mode, `[10:8]`=mailbox_sel, `[15:12]`=spinlock_force_unlock).
  - `0x2C`: `ADDR_MP_STATUS` (RO: `[3:0]`=core_halted, `[7:4]`=spinlock_status, `[11:8]`=barrier_waiting, `[15:12]`=active_cores, `[23:16]`=core0_pc, `[31:24]`=core1_pc).
  - `0x7C`: `ADDR_MP_MAILBOX` (RW: 32-bit window mapping 4 consecutive 8-bit mailboxes starting at `mailbox_sel`).
- **Microcode Instructions**:
  - `CORE_ID` (`0xFC00`), `SPINLOCK_ACQ <id>` (`0xFD00..0xFD03`), `SPINLOCK_REL <id>` (`0xFE00..0xFE03`), `BARRIER_WAIT` (`0xFF00`), `MB_READ <id>` (`0xF800..0xF807`), `MB_WRITE <id>` (`0xF900..0xF907`).

---

## 7. Electrical & Timing Specifications

### Absolute Maximum Ratings
- Core Supply Voltage ($V_{DD}$): $-0.3\,\text{V}$ to $+1.32\,\text{V}$ (ASIC Core) / $+3.6\,\text{V}$ (I/O Ring)
- DC Input Voltage on GPIO: $-0.5\,\text{V}$ to $V_{DDIO} + 0.5\,\text{V}$ (5V tolerant with external current-limiting resistor)
- Maximum Output Current per Pin: $\pm 12\,\text{mA}$

### Recommended Operating Conditions
- System Clock Frequency ($f_{CLK}$): $1\,\text{MHz}$ to $60\,\text{MHz}$ (Nominal $50\,\text{MHz}$ on GW5AST / Jane Street ASIC).
- GPIO Pull-up Resistor for Open-Drain (I2C, 1-Wire, Joybus): $1.0\,\text{k}\Omega$ to $4.7\,\text{k}\Omega$.

---

## 8. Assembly Programming & Toolchain Reference

Programs are compiled using the bundled Python assembler `python/omnibus_asm.py`:
```bash
python python/omnibus_asm.py examples/ws2812_rainbow_demo.asm -o build/ws2812.hex
```

### Complete Example 1: WS2812B 24-Bit RGB NeoPixel Frame Generator
```asm
; ==============================================================================
; OmniBus NeoPixel Driver (24-bit GRB Transmission)
; ==============================================================================
PINMAP tx=0, rx=1, sck=2, cs=3
CFG_OD 0x00                     ; Push-pull on TX pin 0
ASSIST PULSE_CFG, NEOPIXEL      ; 800 kHz active-high pulse mode

; Send Green Byte (0x55)
ALU MOV, acc, 0x55
ALU MOV, osr, acc
OUT tx, 8

; Send Red Byte (0xAA)
ALU MOV, acc, 0xAA
ALU MOV, osr, acc
OUT tx, 8

; Send Blue Byte (0x33)
ALU MOV, acc, 0x33
ALU MOV, osr, acc
OUT tx, 8

; Reset Latch (>50 us low)
SET tx, 0, 2500
NOP
```

### Complete Example 2: SNES 16-Bit Gamepad Controller Reader
```asm
; ==============================================================================
; OmniBus SNES Controller Host Reader
; ==============================================================================
PINMAP tx=0, rx=0, sck=1, cs=2  ; Pin 2 = LATCH, Pin 1 = CLOCK, Pin 0 = DATA
CFG_OD 0x00
ASSIST GAMEPAD_CFG, SNES, LATCH=30

; Trigger autonomous 16-clock gamepad sample sequence
IN rx, 8, 25                    ; Sample 16 bits; lower byte latches in ISR

; Read lower 8 buttons (B, Y, SELECT, START, UP, DOWN, LEFT, RIGHT)
PUSH                            ; Send lower byte to host RX FIFO

; Read upper 8 buttons (A, X, L, R, signature bits)
ASSIST READ, PAD_HIGH           ; acc <= pad_shift_reg[15:8]
ALU MOV, isr, acc
PUSH                            ; Send upper byte to host RX FIFO
NOP
```

### Complete Example 3: RISC-V DTM IDCODE Scan via JTAG TAP Controller
```asm
; ==============================================================================
; OmniBus RISC-V JTAG DTM IDCODE Scan (IEEE 1149.1)
; Pin 0 = TDI, Pin 1 = TCK, Pin 2 = TMS, Pin 3 = TDO
; ==============================================================================
PINMAP 0, 3, 1, 2
JTAG_CFG 1
JTAG_NAV RESET                  ; 5 clocks TMS=1 to Test-Logic-Reset
JTAG_NAV IDLE                   ; Step to Run-Test/Idle
JTAG_NAV SHIFT_DR               ; Select-DR -> Capture-DR -> Shift-DR

; Scan 32-bit IDCODE (4 bytes)
JTAG_SHIFT 8, EXIT=0            ; Byte 0 (bits 7:0)
PUSH
JTAG_SHIFT 8, EXIT=0            ; Byte 1 (bits 15:8)
PUSH
JTAG_SHIFT 8, EXIT=0            ; Byte 2 (bits 23:16)
PUSH
JTAG_SHIFT 8, EXIT=1            ; Byte 3 (bits 31:24) with auto-Exit1-DR
PUSH

JTAG_NAV IDLE                   ; Return to Run-Test/Idle
halt:
JMP halt
```

### Complete Example 4: ARM CoreSight & Hybrid RISC-V SWD Probe
```asm
; ==============================================================================
; OmniBus ARM SWD / CoreSight Debug Port Probe
; Pin 0 = SWDIO (Bidirectional), Pin 1 = SWCLK (Clock output)
; ==============================================================================
PINMAP 0, 0, 1, 2
SWD_CFG 1
SWD_RESET 1                     ; 54 clocks line reset + 0xE79E JTAG-to-SWD switch

; Request DP IDCODE (APnDP=0, RnW=1, Addr=0x00)
SWD_REQ DP, READ, 0x00
JMP SWD_OK, read_idcode
MOV acc, 0xFF                   ; Error indicator
MOV isr, acc
PUSH
JMP halt

read_idcode:
SWD_RD32                        ; Read 32 bits + parity bit + turnaround
JMP CARRY, parity_err

; Push 4 DP IDCODE bytes to RX FIFO
ASSIST READ, SWD_DATA, 0
PUSH
ASSIST READ, SWD_DATA, 1
PUSH
ASSIST READ, SWD_DATA, 2
PUSH
ASSIST READ, SWD_DATA, 3
PUSH
JMP halt

parity_err:
MOV acc, 0xEE
MOV isr, acc
PUSH
halt:
JMP halt
```

---

## 13. Formal Verification & Silicon Invariant Proofs (SymbiYosys / SVA)

The ProtocolEmulator hardware architecture is formally proven using **SymbiYosys** (Yosys + SMTBMC + Yices2/Z3) across 8 verification domains:

| Suite | Scope | Mathematical Invariant | Verification Engines |
| :--- | :--- | :--- | :--- |
| **FIFO** | TX/RX & Wishbone FIFOs | $\text{count} \le \text{DEPTH} \land \neg(\text{full} \land \text{wr}) \land \neg(\text{empty} \land \text{rd})$ | BMC (10), $k$-induction (10), CVR (15) |
| **BusSafety** | Open-drain GPIO arbitration | $\forall p, \quad \neg(o\_gpio\_oe[p] \land o\_gpio[p])$ | BMC (10), $k$-induction (10), CVR (6) |
| **Wishbone** | OmniBus B4 Slave Interface | Single-cycle ACK termination, no hung transactions | BMC (10), $k$-induction (10), CVR (10) |
| **TimingZeroJitter** | Microcode Determinism | $\Delta \text{Delay}(t) = -1/\text{cycle}$; exact $BAUD/$HBAUD delays | BMC (10), $k$-induction (10), CVR (15) |
| **CallStack** | Hardware Subroutines & DJNZ | LIFO stack pointer bounds, ret address preservation | BMC (10), $k$-induction (10), CVR (15) |
| **ALU** | Micro-ALU & CRC-32 Accelerator | Arithmetic/logic accuracy and CRC-32 polynomial steps | BMC (10), $k$-induction (10), CVR (15) |
| **GlitchMitM** | Fault Injection & MitM Matcher | Glitch pulse width, active polarity, and pin isolation | BMC (10), $k$-induction (10), CVR (15) |
| **BIST** | PRBS-7 LFSR & Loopback | $X^7 + X^6 + 1$ non-zero progression and loopback routing | BMC (10), $k$-induction (10), CVR (15) |

For complete invariant definitions and reproduction commands, refer to [`documentation/task30.md`](file:///c:/Workspace/ASIC/ProtocolEmulator/documentation/task30.md).

---

## 14. OmniBus Studio Web IDE & Behavioral Silicon Emulator

The OmniBus architecture includes an in-browser graphical development environment located in [`web_ide/`](file:///c:/Workspace/ASIC/ProtocolEmulator/web_ide/):

- **In-Browser Macro Assembler**: Real-time compilation of 16-bit microcode with label resolution, constant folding, and sidecar delay expansion.
- **Cycle-Accurate Micro-Engine**: Behavioral simulation of all 16 opcodes, hardware assists, 4-level call stack, ALU flags, and open-drain GPIO states.
- **Interactive Logic Analyzer**: Multi-channel canvas rendering digital traces for pins `UIO[7:0]`, internal glitch signals, and SERDES activity with zoom, pan, and $\Delta t$ delta cursors.
- **WebSerial Physical Flasher**: In-system programming to physical FPGA development boards (**Tang Console 60K**, **Tang Nano 20K**, **Tang Nano 9K**) via the `OmniBootloader` protocol.
- **Web Audio API Bridge**: Live audio synthesis from simulated PDM DAC and Chiptune square-wave tones.

Refer to [`documentation/task31.md`](file:///c:/Workspace/ASIC/ProtocolEmulator/documentation/task31.md) for detailed architecture and usage guides.

---

## 15. OmniBus Software Development Kit (SDK) & Assembly Standard Library

The official developer SDK is available under [`sdk/`](file:///c:/Workspace/ASIC/ProtocolEmulator/sdk/):

- **Assembly Include Headers (`sdk/include/`)**: Modular `.inc` files (`omnibus.inc`, `uart.inc`, `i2c.inc`, `spi.inc`, `ws2812.inc`, `joybus.inc`, `chiptune.inc`, `mitm.inc`) with standard timing constants and pin bindings.
- **Python Toolchain & Host Driver (`sdk/omnibus/`)**: Complete host API for in-system flashing, FIFO data streaming, waveform profiler queries, and fault injection.
- **Declarative Protocol DSL (`omnibus.dsl`)**: Python timing synthesizer generating cycle-exact 16-bit microcode from high-level protocol descriptions.
- **Turnkey CLI Tools**: Command-line utilities (`omnibus`, `omnibus-load`, `omnibus-fuzz`, `omnibus-profiler`).

Refer to [`documentation/task32.md`](file:///c:/Workspace/ASIC/ProtocolEmulator/documentation/task32.md) for full SDK API specifications and tutorial guides.

---

## 16. Universal Verification Methodology (pyUVM) & RTL Mutation Testing

OmniBus incorporates an enterprise-grade ASIC verification environment standardizing on Python UVM (**pyUVM**) with Cocotb and an automated **RTL Mutation Testing** suite.

### A. pyUVM Verification Architecture
Located in [`test_rtl/uvm/pyuvm/ProtocolEmulator/`](file:///c:/Workspace/ASIC/ProtocolEmulator/test_rtl/uvm/pyuvm/ProtocolEmulator/):

- **Transaction Sequence Items**:
  - `OmniBusProgramItem`: Microcode program loading transaction via dual-port IMEM programming port (`i_prog_en`, `i_prog_we`, `i_prog_addr`, `i_prog_data`).
  - `OmniBusStimulusItem`: Host FIFO transactions (`i_data`, `i_tx_valid`), GPIO stimulus injection (`i_gpio`), and clock cycle step control.
  - `OmniBusSampledItem`: Passive monitor observation packets broadcasting pin states (`o_gpio`, `o_gpio_oe`), FIFO pushes (`o_data`, `o_rx_push`), and pop events (`o_tx_pop`).
- **UVM Hierarchy**:
  - `OmniBusDriver`: Drives IMEM programming sequences, host FIFO byte streaming, and physical GPIO pin events.
  - `OmniBusMonitor`: Passive monitor observing all bus transactions on active clock edges and publishing to an analysis port (`self.ap`).
  - `OmniBusScoreboard`: Inherits from `uvm_subscriber`, continuously evaluating monitor broadcasts against deterministic expected queues (FIFO outputs, UART frame bytes, SPI/I2C transactions) with zero error tolerance.
  - `OmniBusCoverage`: Real-time functional coverage collector tracking 100% ISA opcode coverage, 100% Micro-ALU sub-operation coverage, and 100% CRC polynomial coverage.
- **Verification Sequences**:
  1. `ALUComprehensiveSequence`: Validates all 15 ALU arithmetic, logic, and register shift operations.
  2. `ControlFlowSequence`: Tests hardware subroutine call stack (`CALL`/`RET`), unconditional jumps, and condition code evaluations (`Z`, `NZ`, `C`, `NC`).
  3. `CRCVerificationSequence`: Checks hardware polynomial generation across CRC-8 Dallas, CRC-8 SMBus, CRC-16 CCITT, CRC-16 Modbus, and CRC-32 Ethernet FCS.
  4. `FIFOPushPullSequence`: Verifies synchronous host FIFO push/pull operations and full/empty backpressure flags.
  5. `SPITransferSequence`: Tests SPI Master full-duplex transfers with automatic `sck_pin` generation.
  6. `I2CTransactionSequence`: Validates I2C open-drain bidirectional bit transfers and clock line arbitration.
  7. `AssistGlitchMitMSequence`: Verifies hardware stream assists, bit-stuffing error detection, and pattern matching fault triggers.
  8. `GPIOAndPinmapSequence`: Tests dynamic pin remapping (`PINMAP`) and per-pin open-drain mask configurations (`CFG_OD`).
  9. `UARTFullDuplexSequence`: Validates 8-N-1 UART framing and full-duplex loopback echoing at 115,200 baud.
  10. `RandomizedInstructionStressSequence`: Constrained-random instruction stream fuzzing under active clock cycles.

### B. RTL Mutation Testing & Fault Injection Analysis
Located in [`test_rtl/mutation/ProtocolEmulator/`](file:///c:/Workspace/ASIC/ProtocolEmulator/test_rtl/mutation/ProtocolEmulator/):

An automated AST and syntactic fault injector generates 20 realistic physical RTL defect mutants across 8 mutation operator classes:
- **AOR (Arithmetic Operator Replacement)**: ALU addition, subtraction, negation, and counter step mutation.
- **ROR (Relational Operator Replacement)**: Branch comparator condition inversion (`Z`, `C`, stack depth).
- **LCR (Logical Connector Replacement)**: Parity check and flag update logic faults.
- **SOR (Shift Operator Replacement)**: Deserializer/serializer bit shift direction and bitmask truncation.
- **SCR (Stack & Control Replacement)**: Call stack pointer saturation and index overflow defects.
- **FPR (FIFO & Protocol Replacement)**: FIFO push/pop strobe generation and handshaking faults.
- **FSR (Framing & State Replacement)**: Stream assist error latches and CRC accumulation faults.
- **ODR (Open-Drain Driver Replacement)**: Open-drain active pull-up contention violations.

**Campaign Result**: **100.00% Mutation Kill-Rate** (20/20 mutants killed, 0 surviving mutants).

For complete test logs and kill matrices, refer to [`documentation/task33.md`](file:///c:/Workspace/ASIC/ProtocolEmulator/documentation/task33.md).
