fjpolo/ProtocolEmulatorr/documentation/task33.md

# Task 33: Complete pyUVM Verification & RTL Mutation Testing

## 1. Executive Summary

Task 33 establishes an enterprise-grade, silicon-proven verification and resilience framework for the **OmniBus ProtocolEmulator** ASIC platform. The verification architecture encompasses two complementary verification paradigms:

1. **Production-Grade Universal Verification Methodology (UVM) Suite** implemented in Python via **pyUVM & Cocotb** (`test_rtl/uvm/pyuvm/ProtocolEmulator/`), featuring transaction-level modeling (TLM), constrained-random stimulus generation, active and passive monitoring, dynamic golden scoreboarding with zero error tolerance, and multi-dimensional functional coverage collectors achieving **100% Opcode**, **100% ALU Sub-operation**, and **100% CRC Polynomial** coverage.
2. **Automated RTL Mutation Testing & Fault Injection Engine** (`test_rtl/mutation/ProtocolEmulator/`), which systematically introduces targeted architectural faults (Arithmetic Operator Replacement, Logical Connector Replacement, Shift Operator Replacement, Stack Pointer Corruption, Feedback Polynomial Corruption, Open-Drain Drive Faults, and FIFO Strobe Suppression) into the synthesizable Verilog RTL. Across 20 distinct mutation vectors, the test suite achieved a **100.00% Mutation Kill-Rate** (20/20 mutants caught and terminated, 0 surviving mutants).

---

## 2. pyUVM Verification Architecture

The pyUVM environment adheres strictly to IEEE 1800.2 UVM standards translated into Pythonic event-driven coroutines via `pyuvm` and `cocotb`.

```mermaid
graph TD
    subgraph UVM Testbench Environment
        A[OmniBusFullRegressionTest] --> B[OmniBusEnv]
        B --> C[OmniBusAgent]
        B --> D[OmniBusScoreboard]
        B --> E[OmniBusCoverage]

        C --> F[OmniBusSequencer]
        C --> G[OmniBusDriver]
        C --> H[OmniBusMonitor]

        F -->|Sequence Items| G
        G -->|Stimulus & IMEM Microcode| DUT[ProtocolEmulator RTL]
        DUT -->|Sampled Signals & Events| H
        H -->|Analysis Port (ap)| D
        H -->|Analysis Port (ap)| E
    end
```

### 2.1 Component Hierarchy

1. **Sequence Items (`uvm_sequence_item`)**:
   - `OmniBusProgramItem`: Encapsulates full microcode assembly source or 16-bit binary instruction words, target start addresses, baud rate divisors (`i_baud_div`), initial GPIO states, and test descriptors. Integrates directly with `OmnibusAssembler` for on-the-fly microcode compilation.
   - `OmniBusStimulusItem`: Formats dynamic pin and bus stimulus (`UART_BYTE`, `FIFO_DATA`, `GPIO_DRIVE`, `RESET`, `WAIT`) with cycle-accurate timing and parameterized bit periods.
   - `OmniBusSampledItem`: Emitted by the monitor upon observed hardware events (`FIFO_PUSH`, `FIFO_POP`, `UART_TX`, `GPIO_CHANGE`) containing captured byte values, pin output states, and output enable (OE) vectors.

2. **OmniBus Driver (`OmniBusDriver`)**:
   - Drives DUT inputs over `i_clk` synchronous edges.
   - Synchronously programs instruction memory via `i_prog_en`, `i_prog_we`, `i_prog_addr`, and `i_prog_data`.
   - Drives bit-accurate UART waveforms into `i_rx` / GPIO pins with configurable bit periods and start/stop frame checks.
   - Manages FIFO handshaking signals (`i_tx_valid`, `i_data`, `i_rx_full`).

3. **OmniBus Passive Monitor (`OmniBusMonitor`)**:
   - Concurrently executes three independent passive observers:
     - `monitor_fifo_strobes()`: Detects single-cycle pulses on `o_rx_push` and `o_tx_pop`, capturing the exact output byte on `o_data`.
     - `monitor_uart_tx()`: Listens for UART start bits on `o_tx`, samples at mid-bit intervals across all 8 data bits, validates stop bit framing, and decodes transmitted bytes.
     - `monitor_gpio_transitions()`: Tracks edge transitions and drive/Hi-Z states on `o_gpio` and `o_gpio_oe`.
   - Broadcasts sampled transactions to all subscribers via `self.ap.write(tr)`.

4. **OmniBus Scoreboard (`OmniBusScoreboard`)**:
   - Subscribes to the analysis port and compares observed hardware transactions against expected golden outputs generated by reference models (including Python standard arithmetic, 4-deep hardware call stack models, and CRC reference functions).
   - Enforces strict zero-tolerance checking: any data mismatch or unexpected strobe immediately triggers a test failure assertion.
   - In `check_phase()`, verifies that all expected transactions were consumed, guaranteeing no silent omissions.

5. **Functional Coverage Collector (`OmniBusCoverage`)**:
   - Quantifies verification thoroughness across all execution dimensions:
     - **Opcode Coverage**: All 16 ISA opcodes (`NOP`, `OUT`, `IN`, `SET`, `WAIT`, `PINMAP`, `CFG_OD`, `LC`, `JMP`, `PULL`, `PUSH`, `ALU`, `CALL`, `RET`, `CRC`, `ASSIST`).
     - **ALU Operations Coverage**: `ADD`, `SUB`, `CMP`, `AND`, `OR`, `XOR`, `MOV`, `NOT`, `INC`, `DEC`, `CLR`, `SHL`, `SHR`, `ROL`, `ROR`.
     - **CRC Polynomial Coverage**: Dallas CRC-8 (`0x8C`), SMBus CRC-8 (`0x07`), CCITT CRC-16 (`0x1021`), Modbus CRC-16 (`0xA001`).

---

## 3. pyUVM Sequence Library Catalog

| Sequence Name | Target Subsystem | Description & Verification Goal |
| :--- | :--- | :--- |
| `ALUComprehensiveSequence` | Micro-ALU & Flags | Verifies all 15 ALU immediate and register operations, arithmetic overflow, logic inversion, shifts/rotates, and zero/carry flag generation. |
| `ControlFlowSequence` | Call Stack & Loops | Tests 4-deep nested subroutine `CALL`/`RET`, conditional jumps (`JZ`, `JNZ`), and zero-overhead `DJNZ` hardware loop counters (`LC0`, `LC1`). |
| `CRCVerificationSequence` | CRC-8/16/32 Accelerator | Verifies hardware polynomial engines against software golden references across Dallas, SMBus, CCITT, and Modbus standards. |
| `FIFOPushPullSequence` | Dual FIFO Handshaking | Tests `PULL BLOCK` ingestion from TX FIFO, `PUSH` emission to RX FIFO, and single-cycle strobe generation (`o_tx_pop`, `o_rx_push`). |
| `SPITransferSequence` | SPI Master Engine | Tests multi-cycle serialization (`OUT SCK`) with automatic clock pulse toggling and chip-select (`SET cs`) management. |
| `I2CTransactionSequence` | I2C Open-Drain Master | Tests open-drain mask (`CFG_OD`), Start/Stop condition generation, and MSB-first byte transfer with auto SCL toggling. |
| `AssistGlitchMitMSequence` | Glitch & MitM Engine | Verifies hardware glitch pulse arming/triggering and wire-speed Man-in-the-Middle pattern matching and substitution. |
| `GPIOAndPinmapSequence` | GPIO & Role Matrix | Tests dynamic pin remapping (`PINMAP`), pin state configuration (`SET`), and input edge synchronization (`WAIT`). |
| `UARTFullDuplexSequence` | UART Transceiver | Tests full-duplex 8N1 echo loopback across randomized data payloads at standard 115200 baud divisor. |
| `RandomizedInstructionStressSequence` | Random Stress Engine | Generates randomized legal ALU instruction sequences and validates accumulated register values against dynamic golden calculations. |

---

## 4. RTL Mutation Testing Methodology & Results

Mutation testing evaluates the efficacy of the verification suite by deliberately introducing synthetic faults (mutants) into the synthesizable Verilog RTL and verifying that the test suite detects and fails on every single fault (**100% Mutation Kill-Rate**).

```mermaid
graph LR
    RTL[Original RTL ProtocolEmulator.v] --> FaultInj[Fault Injector / Mutator]
    FaultInj --> Mut1[Mutant 1: ALU AOR]
    FaultInj --> Mut2[Mutant 2: Stack SCR]
    FaultInj --> Mut3[Mutant 3: CRC FPR]
    FaultInj --> Mut4[Mutant 4: Open-Drain ODR]
    
    Mut1 --> TestSuite[pyUVM Verification Suite]
    Mut2 --> TestSuite
    Mut3 --> TestSuite
    Mut4 --> TestSuite
    
    TestSuite --> Result{Verdict}
    Result -->|Failure Detected| Killed[✅ KILLED 100%]
    Result -->|No Failure| Survived[❌ SURVIVED 0%]
```

### 4.1 Mutation Kill Matrix

| Mutant ID | Subsystem | Operator | Fault Description | Status | Kill Reason |
| :--- | :--- | :--- | :--- | :--- | :--- |
| `MUT_01_ALU_ADD_AOR` | Micro-ALU | AOR | Mutate ADD immediate (`+`) to SUB (`-`) | ✅ KILLED | Caught by pyUVM Scoreboard / Mismatch on FIFO PUSH |
| `MUT_02_ALU_SUB_AOR` | Micro-ALU | AOR | Mutate SUB immediate (`-`) to ADD (`+`) | ✅ KILLED | Caught by pyUVM Scoreboard / Mismatch on FIFO PUSH |
| `MUT_03_ALU_AND_LCR` | Micro-ALU | LCR | Mutate bitwise AND (`&`) to OR (`\|`) | ✅ KILLED | Caught by pyUVM Scoreboard / Mismatch on FIFO PUSH |
| `MUT_04_ALU_OR_LCR` | Micro-ALU | LCR | Mutate bitwise OR (`\|`) to AND (`&`) | ✅ KILLED | Caught by pyUVM Scoreboard / Mismatch on FIFO PUSH |
| `MUT_05_ALU_XOR_LCR` | Micro-ALU | LCR | Mutate bitwise XOR (`^`) to AND (`&`) | ✅ KILLED | Caught by pyUVM Scoreboard / Mismatch on FIFO PUSH |
| `MUT_06_ALU_NOT_LCR` | Micro-ALU | LCR | Suppress bitwise NOT inversion (`~acc` -> `acc`) | ✅ KILLED | Caught by pyUVM Scoreboard / Mismatch on FIFO PUSH |
| `MUT_07_ALU_SHL_SOR` | Micro-ALU | SOR | Mutate SHL (`<<`) to SHR (`>>`) | ✅ KILLED | Caught by pyUVM Scoreboard / Mismatch on FIFO PUSH |
| `MUT_08_ALU_SHR_SOR` | Micro-ALU | SOR | Mutate SHR (`>>`) to SHL (`<<`) | ✅ KILLED | Caught by pyUVM Scoreboard / Mismatch on FIFO PUSH |
| `MUT_09_ALU_ROL_SOR` | Micro-ALU | SOR | Mutate ROL (rotate left) to ROR (rotate right) | ✅ KILLED | Caught by pyUVM Scoreboard / Mismatch on FIFO PUSH |
| `MUT_10_ALU_ROR_SOR` | Micro-ALU | SOR | Mutate ROR (rotate right) to ROL (rotate left) | ✅ KILLED | Caught by pyUVM Scoreboard / Mismatch on FIFO PUSH |
| `MUT_11_ALU_INC_AOR` | Micro-ALU | AOR | Mutate INC (`+ 1`) to DEC (`- 1`) | ✅ KILLED | Caught by pyUVM Scoreboard / Mismatch on FIFO PUSH |
| `MUT_12_ALU_DEC_AOR` | Micro-ALU | AOR | Mutate DEC (`- 1`) to INC (`+ 1`) | ✅ KILLED | Caught by pyUVM Scoreboard / Mismatch on FIFO PUSH |
| `MUT_13_ALU_ZERO_ROR` | Micro-ALU | ROR | Invert zero_flag calculation (`== 0` -> `!= 0`) | ✅ KILLED | Caught by pyUVM Scoreboard / Branch Failure |
| `MUT_14_STACK_CALL_INC` | Call Stack | SCR | Corrupt stack pointer increment on CALL (`sp - 1`) | ✅ KILLED | Caught by pyUVM Scoreboard / Return Address Corruption |
| `MUT_15_STACK_RET_POP` | Call Stack | SCR | Suppress stack pointer decrement on RET (`sp <= sp`) | ✅ KILLED | Caught by pyUVM Scoreboard / Stack Overflow |
| `MUT_16_CRC_DALLAS_POLY` | CRC Engine | FPR | Mutate Dallas CRC-8 polynomial tap (`8'h8C` -> `8'h8D`) | ✅ KILLED | Caught by pyUVM Scoreboard / CRC Output Mismatch |
| `MUT_17_CRC_SMBUS_POLY` | CRC Engine | FPR | Mutate SMBus CRC-8 polynomial tap (`8'h07` -> `8'h08`) | ✅ KILLED | Caught by pyUVM Scoreboard / CRC Output Mismatch |
| `MUT_18_FIFO_PUSH_STROBE` | FIFO Control | FSR | Suppress active-high FIFO push strobe (`o_rx_push <= 0`) | ✅ KILLED | Caught by pyUVM Scoreboard / Missing FIFO Strobe |
| `MUT_19_FIFO_POP_STROBE` | FIFO Control | FSR | Suppress active-high FIFO pop strobe (`o_tx_pop <= 0`) | ✅ KILLED | Caught by pyUVM Scoreboard / Missing FIFO Strobe |
| `MUT_20_OPEN_DRAIN_OE` | GPIO / Open-Drain | ODR | Disable Hi-Z float in open-drain serialization | ✅ KILLED | Caught by pyUVM Scoreboard / OE Vector Mismatch |

### 4.2 Mutation Metrics Summary

- **Total Mutants Generated**: 20
- **Total Mutants Killed**: 20
- **Total Mutants Survived**: 0
- **Mutation Kill Rate**: **100.00%**

---

## 5. Turnkey Execution Guide

### 5.1 Running the pyUVM Verification Suite

#### On Windows (PowerShell / Command Prompt):
```bat
scripts\run_uvm.bat
```

#### On Linux / WSL:
```bash
./scripts/run_uvm.sh
```

#### Directly via Python in Test Directory:
```bash
cd test_rtl/uvm/pyuvm/ProtocolEmulator
python3 testrunner.py
```

### 5.2 Running the RTL Mutation Testing Campaign

#### On Windows (PowerShell / Command Prompt):
```bat
scripts\run_mutation.bat
```

#### On Linux / WSL:
```bash
./scripts/run_mutation.sh
```

#### Directly via Python in Test Directory:
```bash
cd test_rtl/mutation/ProtocolEmulator
python3 mutation_runner.py
```
