fjpolo/ProtocolEmulatorr/html/Jane Street Blog - Can you design a chip_ Announcing the protocol emulator ASIC competition_files/oscilloscope-clean.png

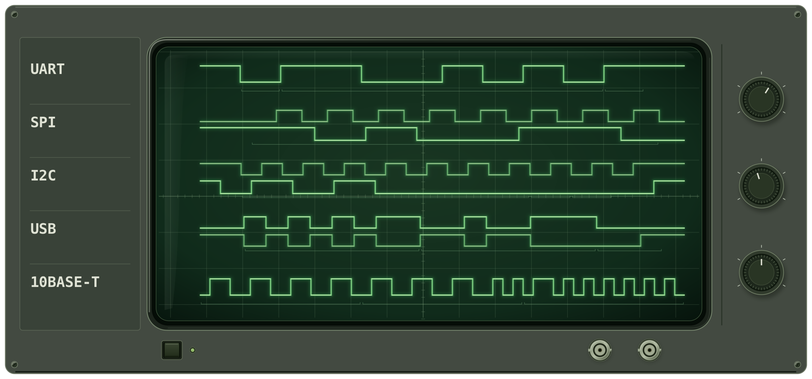
html/Jane Street Blog - Can you design a chip_ Announcing the protocol emulator ASIC competition_files/oscilloscope-clean.png
