fjpolo/ProtocolEmulatorr/html/Jane Street Blog - Can you design a chip_ Announcing the protocol emulator ASIC competition_files/scientist_testing.jpg

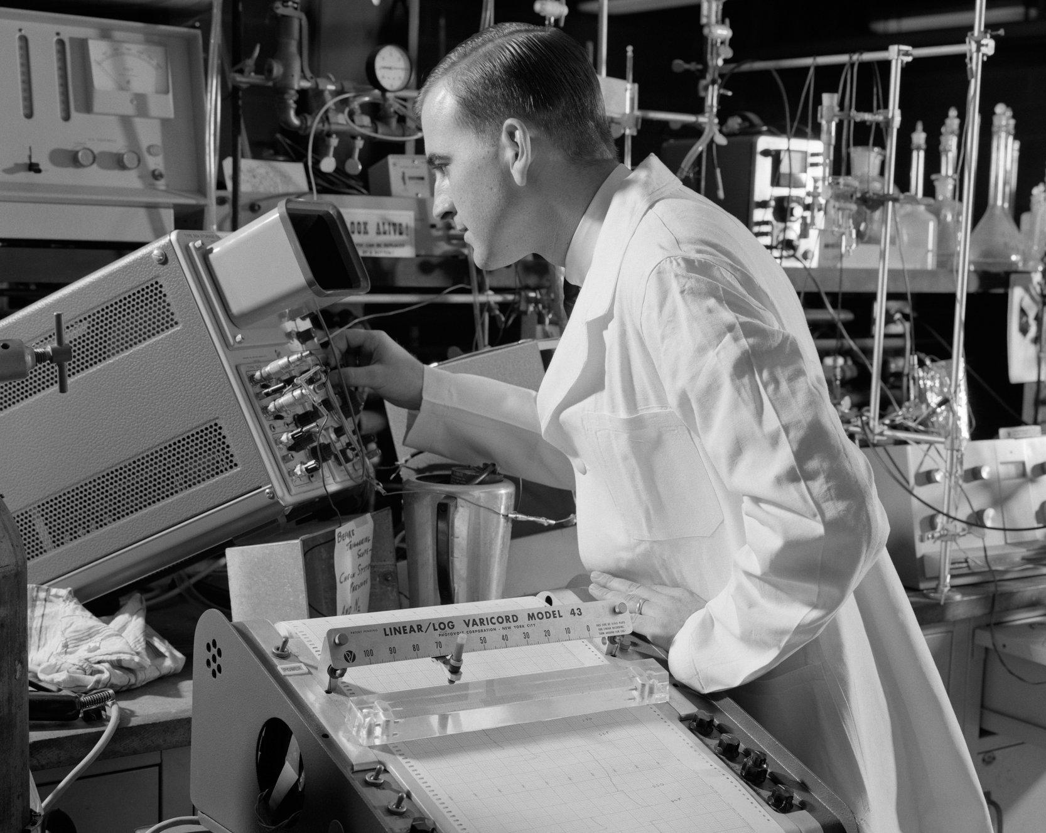
html/Jane Street Blog - Can you design a chip_ Announcing the protocol emulator ASIC competition_files/scientist_testing.jpg
