fjpolo/ProtocolEmulatorr/test_rtl/uvm/icarus_uvm/ProtocolEmulator/tb_top.sv

`timescale 1ps/1ps
// Remove the uvm_macros.svh include

module tb_top;
    bit clk;
    logic reset_n;
    logic [7:0] data_in;
    logic [7:0] data_out;
    
    // Clock generation
    initial begin
        clk = 0;
        forever #500 clk = ~clk; // 1GHz clock
    end
    
    // DUT instantiation
    ProtocolEmulator dut (
        .i_clk(clk),
        .i_reset_n(reset_n),
        .i_data(data_in),
        .o_data(data_out)
    );
    
    // Simple test
    initial begin
        reset_n = 0;
        data_in = 0;
        #1000 reset_n = 1;
        
        // Simple stimulus
        for (int i = 0; i < 10; i++) begin
            data_in = $random;
            @(posedge clk);
        end
        
        $display("Test completed");
        $finish;
    end
endmodule
