fjpolo/ProtocolEmulatorr/rtl/OmniBootloader.v

// =============================================================================
// File        : OmniBootloader.v
// Module      : OmniBootloader
// Description : In-band UART microcode bootloader for the OmniBus architecture.
//               Enables runtime loading, verification, and execution of microcode
//               at 115200 baud on a 50 MHz system clock without FPGA re-synthesis.
//               Supports runtime baud rate divisor configuration via 'B' command.
//               Task 07B: 'D' command sets i_data byte for PULL-based SPI programs.
// License     : MIT License
// =============================================================================

`default_nettype none
`timescale 1ns/1ps

module OmniBootloader #(
    parameter CLK_FREQ_HZ = 50_000_000,
    parameter BAUD_RATE   = 115_200
)(
    input   wire            i_clk,
    input   wire            i_reset_n,
    input   wire            i_rx,
    output  wire            o_tx,
    output  wire            o_prog_active,

    // Runtime baud divisor output → drives ProtocolEmulator.i_baud_div
    output  wire    [15:0]  o_baud_div,

    // SPI data register output → drives ProtocolEmulator.i_data
    // Updated by 'D' command: host sends 'D' <byte> to set the byte for PULL.
    output  wire    [7:0]   o_data_reg,

    // Interface to ProtocolEmulator IMEM
    output  wire            o_prog_en,
    output  reg             o_prog_we,
    output  reg     [6:0]   o_prog_addr,
    output  reg     [15:0]  o_prog_data,
    input   wire    [15:0]  i_prog_rdata
);
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
