fjpolo/ProtocolEmulatorr/(commit log)

2026-09-18 docs: Add software toolchain and assembler concept specification
2026-09-18 feat(core): Implement Task 01 minimal 3-instruction OmniBus core and UART transmitter
2026-09-18 Fix UART
2026-09-19 test(sim): Implement self-checking Cocotb testbench for UART transmitter
    - Add cycle-accurate UARTReceiver with mid-bit sampling in testbench.py
    - Verify framing, zero-jitter bit timing (434 cycles/bit), and payload 'U' (0x55)
    - Verify continuous streaming across JMP loop and PC progression telemetry
    - Support both Icarus Verilog and Verilator across Cocotb 1.x and 2.x
    - Add Makefile and update testrunners and run.sh scripts
    [testbench.py, testrunner_icarus.py, testrunner_verilator.py]
2026-09-19 test(formal): Complete formal verification suite for UART transmitter
    - Add reset assertions, zero-jitter delay invariants, and instruction decoding
    - Add ROM constancy invariants enabling unbounded k-induction proof
    - Fix unreachable cover statement and optimize SBY task depths
    - Update .gitignore for SBY artifacts and set executable permissions on run scripts
    [properties.v]
2026-09-19 feat(task02): implement dynamic register serialization with OSR and OUT opcode
    - Add Output Shift Register (osr) and bit counter (bit_cnt) to ProtocolEmulator.v
    - Implement PULL (0x9) opcode to latch i_data into OSR
    - Implement OUT (0x1) opcode for multi-cycle LSB-first bit serialization
    - Reduce UART microcode from 12 words to 6 words
    - Add tx_busy flag output on o_data[7]
    - Add Cocotb tests for arbitrary dynamic bytes, string streaming, and zero jitter
    - Update formal properties for unbounded k-induction proof and reachability covers
    - Add task02.md architectural specification
    [ProtocolEmulator.v, properties.v, testbench.py]
2026-09-19 feat(synth): add open-source Yosys synthesis flow for Tang Console 60K (GW5A)
    - Add boards/sipeed/console60k/console60k.ys targeting GW5AT-60B (synth_gowin -family gw5a)
    - Add boards/sipeed/console60k/build_yosys.sh runner for one-command synthesis
    - Update boards/sipeed/console60k/src/top.v to default i_data to 8'h55 ('U')
    - Add test_rtl/synth/console60k/ testbench and runner to test_rtl/synth/run_all.sh
    - Update test_rtl/synth/ProtocolEmulator/ProtocolEmulator.ys with -family gw5a and clean headless execution
    - Fix upstream Yosys OSS CAD Suite cells_xtra_gw5a.v syntax errors
    [top.v]
2026-09-21 feat(task03): implement full-duplex UART receiver and echo transceiver with ISR, IN, and WAIT opcodes
    - Add Input Shift Register (isr) and deserializer bit counter (rx_bit_cnt) to ProtocolEmulator.v
    - Implement WAIT (0x4) opcode for deterministic edge and level synchronization
    - Implement IN (0x2) opcode for multi-cycle mid-bit sampling deserialization
    - Implement PUSH (0xA) opcode for internal bus transfer (ISR to OSR and o_data)
    - Add 2-stage input synchronizer for i_rx to protect against metastability
    - Add 9-word UART Echo Transceiver microcode program
    - Map uart_rx to Pin V14 and uart_tx to Pin U15 on Tang Console 60K
    - Update serial_monitor_console60k.ps1 with full-duplex keyboa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
2026-09-21 feat(task04): Runtime-Programmable IMEM with In-Band Hardware Bootloader
    - ProtocolEmulator.v: Expanded PC to 5-bit, IMEM to 32x16-bit dual-port
    distributed RAM with synchronous write port (i_prog_en/we/addr/data)
    and combinational readback (o_prog_rdata). Reset initialises Echo microcode.
    - OmniBootloader.v: New hardware UART bootloader with 3-byte unlock token
    (0xAA 0x55 0x50), command parser (W/R/X), single-byte TX serializer and
    response sequencer. Full UART RX/TX at 115200 baud on 50 MHz clock.
    - top.v: Instantiated OmniBootloader alongside DUT, added 64-cycle Power-On
    Reset generator, TX mux (bootloader/core), PMOD LED telemetry for prog mode.
    - python/omnibus_asm.py: Cust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
    [OmniBootloader.v, ProtocolEmulator.v, echo.asm, hello.asm, omnibus_asm.py, omnibus_loader.py, properties.v, testbench.py]
2026-09-21 feat(task05): 4-Deep Hardware CALL/RET Subroutine Stack
    - ProtocolEmulator.v: Added 4-deep x 5-bit call_stack[0:3] register array
    and 2-bit stack pointer sp. New opcodes:
    CALL (0xC): push pc+1 to call_stack[sp], increment sp (saturates at 3), jump to target
    RET (0xD): decrement sp, restore pc = call_stack[sp] (underflow-safe: stays at 0)
    Stack and sp reset to 0 on !i_reset_n and i_prog_en.
    - omnibus_asm.py: Added CALL and RET to OPCODES dict (0xC, 0xD).
    CALL <label>: encodes as [15:12]=C [4:0]=target. RET: encodes as 0xD000.
    - examples/subroutine_demo.asm: 27-word microcode program demonstrating
    CALL/RET. Main loop calls tx_O (addr 5) and tx_K (addr 16) subroutines,
    each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
    [ProtocolEmulator.v, omnibus_asm.py, properties.v, subroutine_demo.asm, testbench.py]
2026-09-21 feat(task06): Runtime-configurable baud rate via i_baud_div port
    RTL:
    - ProtocolEmulator.v: add input wire [15:0] i_baud_div port
    Magic delay sentinels in instruction delay field:
    9'h1FF () -> use i_baud_div[8:0] (full bit period)
    9'h1FE () -> use i_baud_div[8:0] >> 1 (half bit period)
    All timing instructions (SET/NOP/OUT/IN/WAIT) resolved through
    eff_delay wire; hardcoded delays pass through unchanged.
    - OmniBootloader.v: add reg [15:0] baud_div (default 433 = 115200@50MHz)
    New output port: o_baud_div[15:0]
    New command 'B' (0x42): receives 2-byte MSB:LSB divisor, stores in
    baud_div, responds ACK + echo. New FSM states: CMD_B_HI, CMD_B_LO.
    - boards/sipeed/cons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
    [OmniBootloader.v, ProtocolEmulator.v, echo_configurable.asm, omnibus_asm.py, omnibus_loader.py, testbench.py, top.v]
2026-09-21 chore(task06): add build/flash/run scripts and task06.md spec
    - build_task06.bat: Gowin synthesis + PnR for Task 06 bitstream
    Accepts --clean flag to wipe impl/ before building
    - flash_task06.bat: program bitstream to SPI Flash (default) or SRAM
    --sram: volatile fast load | --build: build-then-flash in one step
    - run_echo_configurable.bat: load echo_configurable.asm with optional
    runtime baud rate change:
    run_echo_configurable.bat 57600 -> SetBaud + upload + terminal
    run_echo_configurable.bat -> default 115200 baud
    - task06.md: full task spec with quick-start guide, baud divisor table,
    'B' command protocol, file manifest, and AI experiment notes
2026-09-21 feat(formal/task06): update properties.v for i_baud_div + eff_delay
    - Header updated to Task 06
    - Added i_baud_div liveness assumption: i_baud_div >= 1 and [8:0] <= 511
    - Replaced all 5 occurrences of ASSERT(delay_cnt == past(delay)) with
    ASSERT(delay_cnt == past(eff_delay)) in the zero-jitter timing contract.
    eff_delay is the resolved sentinel: 9'h1FF -> i_baud_div[8:0],
    9'h1FE -> i_baud_div[8:0]>>1, otherwise delay passes through unchanged.
    - Added Cover 8: sentinel path reachable (delay_cnt loaded from
    i_baud_div[8:0] in non-reset, non-prog cycle)
    Verification: BMC depth-10 PASS, k-induction PASS, cover 8/8 PASS
    [properties.v]
2026-09-21 feat(task07): SPI Mode 0 master in microcode via pin selector ISA extension
    ISA Extension (backward compatible):
    - SET/WAIT instr[11:10] = pin_id: 0=MOSI/TX, 1=SCK, 2=CS_n, 3=MOSI alias
    Old 2-arg SET val, delay -> pin_id=0 (backward compat, all [11:10]=00)
    New 3-arg SET pin, val, delay -> encodes pin_id in [11:10]
    - IN instr[11:9] = bit_count: 0->8bits (compat), 1..7->N bits
    Old IN 8, delay -> [11:9]=0 (backward compat)
    New IN 1, delay -> [11:9]=1 -> 1-bit per clock sample
    RTL (ProtocolEmulator.v):
    - Add output wire o_spi_sck (driven by sck_reg, resets 0)
    - Add output wire o_spi_cs_n (driven by cs_reg, resets 1 = deasserted)
    - SET case: case(pin_id) -> tx_reg/sck_reg/cs_reg
    - IN cas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
    [ProtocolEmulator.v, omnibus_asm.py, spi_loopback.asm, testbench.py, top.v]
2026-09-21 feat(task07b): OUT SCK auto-toggle + OmniBootloader D data command
    OUT SCK extension (backward compatible):
    - OUT SCK, delay -> [15:12]=1, [11:10]=01 (pin_id=SCK), [8:0]=delay
    - Old OUT delay / OUT 8, delay -> [11:10]=00, unchanged (UART compat)
    - Phase 0: tx_reg=osr[7] MSB first, sck_reg=1, wait eff_delay
    - Phase 1: isr shift in rx_in (MISO), sck_reg=0, shift OSR left
    - Full-duplex: MOSI and MISO in one instruction
    - New register: out_sck_phase (1-bit, resets to 0)
    OmniBootloader D command:
    - D <byte> -> spi_data_reg -> o_data_reg -> DUT.i_data
    - Reply: ACK + echo. Resets to 0x00.
    Assembler: OUT SCK, delay via PIN_NAMES detection
    Loader: set_spi_data(), --spi-data HEX flag
    Example: exampl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
    [OmniBootloader.v, ProtocolEmulator.v, omnibus_asm.py, omnibus_loader.py, spi_generic.asm, testbench.py, top.v]
2026-09-21 docs: add task07.md and task08.md
    task07.md: SPI Mode 0 master (pin selector ISA, OUT SCK, D command)
    task08.md: I2C Master plan (OUT SDA, I2CSlaveStub, open-drain loopback)
2026-09-22 feat(gpio): Unified 8-bit GPIO bus with microcode-configurable pin mapping (Option A)
2026-09-22 fix(top): Route uart_rx to DUT RX when SPI is inactive and enable live UART echo
    [top.v]
2026-09-22 feat(task08): I2C Master in microcode with loopback auto-ACK
2026-09-22 feat(examples): add i2c_read example and run_i2c_read.bat for Task 10
2026-09-22 feat(task12): implement 1-Wire protocol, 16-bit delay counter, and OUT/IN 1W instructions
2026-09-22 feat(imem): expand IMEM to 128 words with 4-bank switching and hot-reloading (Task 16)
2026-09-23 feat(stream): Task 17 - Autonomous Stream Accelerators (NRZI & Bit-Stuffer/De-stuffer)
    - Implement hardware NRZI modulator (TX toggle on 0, hold on 1) and demodulator (RX edge detector)
    - Implement autonomous hardware bit-stuffing on TX:
    * USB 1.1 mode: insert '0' stuff bit after 6 consecutive 1s
    * CAN 2.0 mode: insert inverted bit after 5 consecutive identical bits
    - Implement autonomous hardware bit-destuffing on RX:
    * USB 1.1 mode: discard stuffed '0' bit after 6 consecutive 1s
    * CAN 2.0 mode: discard complement after 5 consecutive identical bits
    * Hardware bit-stuff violation detection setting stuff_error on illegal runs
    - Add Opcode 0xF (ASSIST): ASSIST CFG, ASSIST RESET, ASSI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
    [ProtocolEmulator.v, omnibus_asm.py, properties.v, testbench.py]
2026-09-23 feat(pulse): Task 18 - Asymmetric Single-Wire & Retro Physical Protocol Accelerators (WS2812B NeoPixel, N64/GC Joybus, & NES/SNES Gamepad)
2026-09-23 feat(stream): Task 19 - Autonomous Manchester & BMC Stream Accelerator
    - RTL: Implement autonomous 2-phase Manchester & BMC serializer/deserializer
    with half-bit timing resolution (eff_hdelay = eff_delay >> 1)
    - RTL: Implement continuous Manchester code violation detection (manch_error)
    and zero-overhead conditional branch (JMP MANCH_ERR)
    - RTL: Support IEEE 802.3 10BASE-T, Thomas convention, and BMC / FM1
    (S/PDIF, DALI, MIL-STD-1553)
    - Assembler: Add ASSIST MANCH, <IEEE|THOMAS|BMC> and JMP MANCH_ERR syntax
    - Examples: Add 10BASE-T Ethernet packet generator demo (ethernet_10baset_demo.asm)
    - Runners: Add run_manch_demo.bat and run_manch.bat scripts
    - Simulation: Add 4 dedicated Cocotb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
2026-09-23 feat(i2c): Task 21 - Dedicated Hardware I2C / SMBus Slave Engine with autonomous address matching and clock stretching
2026-09-24 Implement Task 23: Dedicated Hardware JTAG TAP Controller & ARM SWD Hardware Sequencer (Supporting RISC-V DTM & ARM CoreSight)
2026-09-24 Task 24: Implement Quad-SPI (QSPI) & Dual/Octal Multi-Lane Flash & PSRAM Host Controller with 100% test pass
2026-09-24 Implement Task 25: Hardware Glitch / Fault Injection & Active Wire-Speed MitM Fuzzing Engine
    [OmniBus_Wishbone.v, ProtocolEmulator.v, glitch_fault_demo.asm, omnibus_asm.py, testbench.py]
2026-09-24 Enable interactive UART console terminal by default in run_glitch.bat
2026-09-24 Fix batch syntax error by replacing parentheses with brackets in echo statement
2026-09-24 feat(dma): implement Task 26 OmniBus DMA Scatter-Gather Controller & Host Memory Streamer
2026-09-24 feat(dma): add FPGA interactive runner flow and microcode demo for run_dma.bat
2026-09-24 chore: track .gitattributes for CRLF enforcement on batch files
2026-09-25 feat(profiler): implement Task 27 Autonomous Waveform Profiler & Auto-Baud Engine
    - Add rtl/OmniBus_Profiler.v with 16-bit transition timer, t_min discovery, idle polarity discriminator, duty-cycle symmetry clock detector, and protocol framing classifier
    - Integrate profiler into rtl/ProtocolEmulator.v with PROFILER_CFG, PROFILER_FILTER, PROFILER_ARM, PROFILER_STOP, PROFILER_RST, ASSIST READ, and JMP PROFILER_DONE/PROFILER_CLOCK
    - Expose profiler over Wishbone B4 slave registers 0x50..0x5C in rtl/OmniBus_Wishbone.v
    - Update python/omnibus_asm.py with new opcodes, macros, and branch conditions
    - Add Cocotb tests in ProtocolEmulator and Wishbone suites (90/90 passing)
    - Create examples/profile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
2026-09-25 fix(gowin): connect Task 28 USB ports in top.v and eliminate multi-driver net on tx_auto_ack_pending in OmniBus_USB_SIE
    [OmniBus_USB_SIE.v, top.v]
2026-09-25 fix(board): invert PMOD o_led vector for active-low LED polarity on Tang Console 60K
    [top.v]
2026-09-25 feat(bist): add live UART telemetry reporting (BIST: S1..S4 OK) and auto-open terminal in run_bist_demo.bat
2026-09-25 fix(bist): use in microcode for exact 115200 baud UART streaming and 0.5s heartbeat
    [bist_self_play.asm]
2026-09-29 docs: update CONCEPT.md, TOOLCHAIN_CONCEPT.md, and fix assembler pin aliases
2026-09-29 feat(sdk): Task 32 OmniBus Software Development Kit (SDK) & Assembly Standard Library
2026-10-01 feat(compiler): Task 34 Omni-C optimizing protocol compiler and dual-track SDK
    - Implement complete Omni-C C-to-Microcode optimizing compiler (sdk/omnibus/compiler/ and python/omnic.py)
    - Support C syntax, automatic for-to-repeat hardware loop optimization (LC0/LC1 with DJNZ), register allocation, and sidecar delay coalescing
    - Add turnkey CLI wrapper batch/shell scripts (omnic.bat, scripts/omnic.bat, scripts/omnic.sh)
    - Deliver standard C protocol library headers (sdk/include/omnic/): omnibus.h, uart.h, i2c.h, spi.h, ws2812.h, onewire.h, audio.h, mitm.h
    - Maintain dual-track SDK supporting both Assembly (.asm / .inc) and C (.c / .h) with dedicated example suites and tests
    - Provide comprehe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
2026-10-01 feat(cli): add omnic.ps1 PowerShell wrappers and console script entrypoints
    - Add omnic.ps1 and scripts/omnic.ps1 for native PowerShell execution (.\omnic)
    - Register omnic and omnibus-cc in setup.py and pyproject.toml console_scripts
    - Upgrade compile_cli in sdk/omnibus/cli.py with full multi-format output support
    - Update C_PROGRAMMING_GUIDE.md with PowerShell and CMD instructions
2026-10-01 Implement Task 35: Multi-Core Symmetric OmniBus Micro-Engine (OmniBus MP) with configurable 1, 2, 4 cores, shared mailboxes, atomic spinlocks, hardware rendezvous barrier, cascade FIFOs, assembler/co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
2026-10-01 Centralize NUM_CORES definition into unified rtl/OmniBus_Config.vh shared across Verilog RTL, Omni-C compiler headers, and Assembler
2026-10-01 feat(web_ide): Add multi-core visualizer, waveform time zoom controls, fit trace, and keyboard shortcuts
2026-10-01 feat(web_ide): Add Omni-C compiler integration, expandable multi-panel layout, and fix waveform logic analyzer rendering
    - Integrate in-browser Omni-C compilation with virtual headers, syntax diagnostics, and ASM preview modal
    - Add draggable layout splitters, layout presets (Max Editor, Wide Editor, Focus Waveform), font scaling, and word wrap
    - Fix waveform viewer coordinate calculation with gutter offset and canvas clipping to eliminate squished traces
    - Fix UI update loop multi-core state property accesses and add live simulation auto-following
2026-10-02 feat(compiler,web_ide): Implement Task 38: Omni-C Optimizing Compiler & Source-Level Debugger
    - Multi-pass optimization pipeline (-O0, -O1, -O2) with delay coalescing, inverse move elimination, SET pin deduplication, NOP folding, jump chain compression, and unreferenced label pruning
    - Added switch/case/default jump table compilation to Python and JS compilers
    - Two-way source-to-binary debug location mappings (#loc:<line>, pcToCLine, cLineToPCs)
    - Web IDE Source-Level Interactive Debugger with gutter breakpoints, F9 source-line stepping, active line indicator, and live register & bank memory telemetry
